mod-bee/modbee-node-uio/images/modbee-node-uio-connections-wh.webp

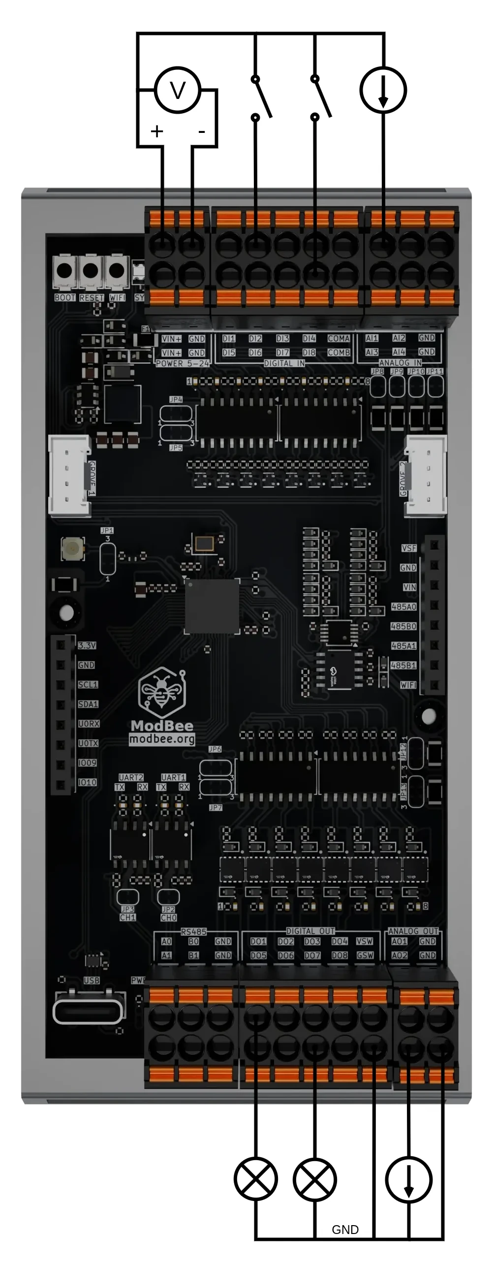
images/modbee-node-uio-connections-wh.webp
