mod-bee/modbee-node-uio/images/node-uio-br-1.webp

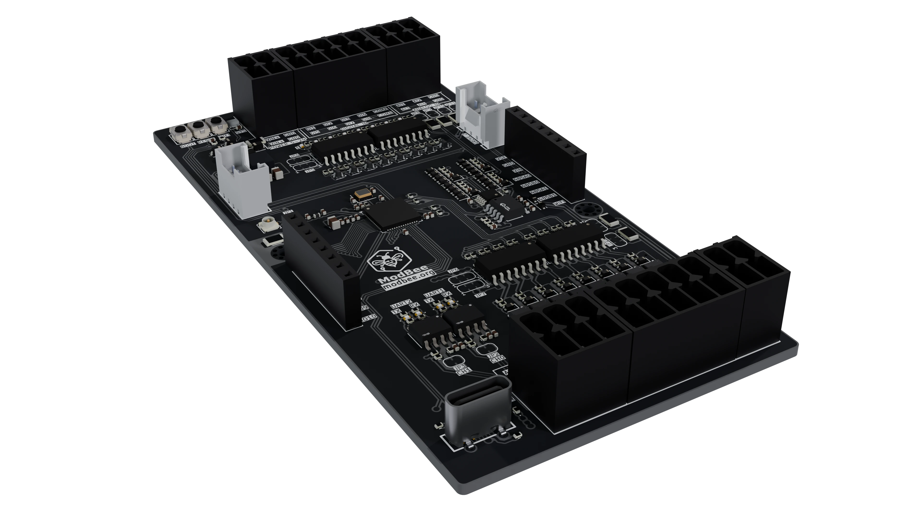
images/node-uio-br-1.webp
