mod-bee/modbee-node-uio/images/node-uio-br-2.webp

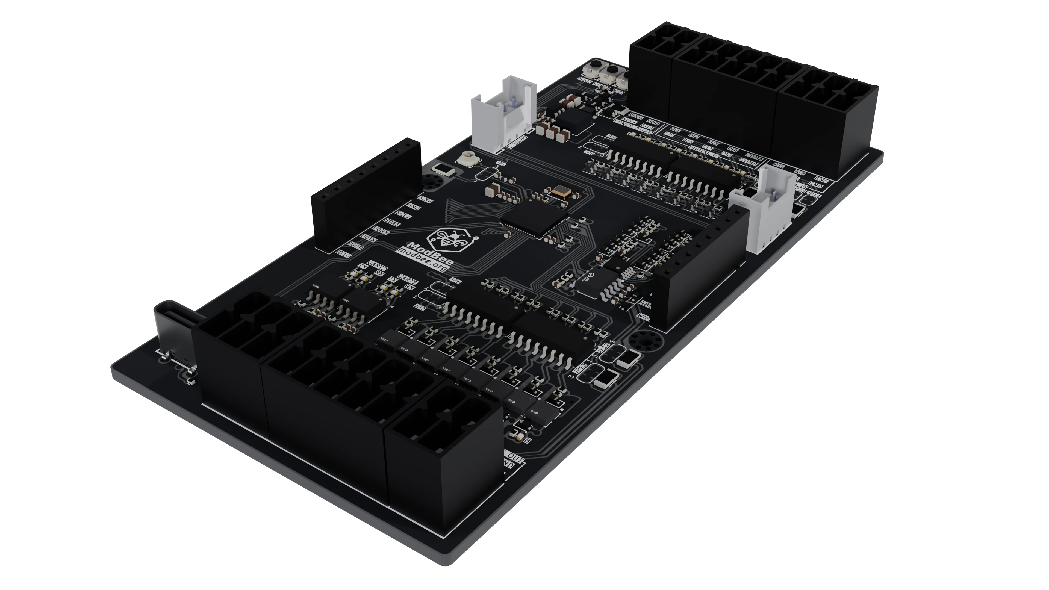
images/node-uio-br-2.webp
