mod-bee/modbee-node-uio/images/node-uio-br-3.webp

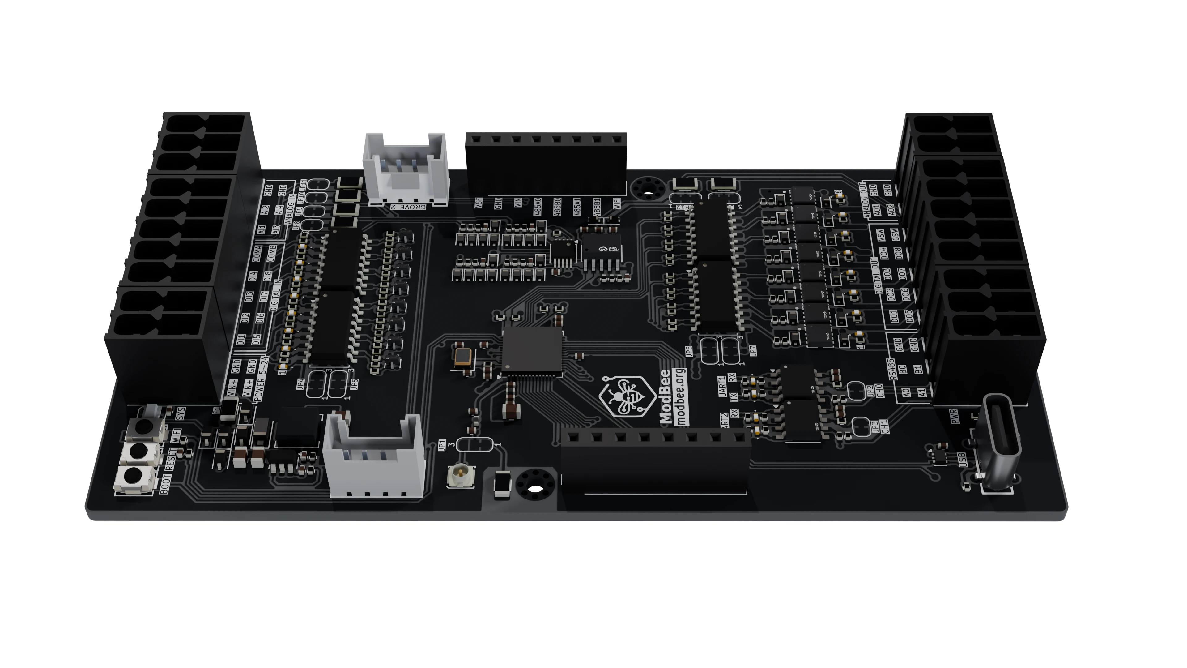
images/node-uio-br-3.webp
