mod-bee/modbee-node-uio/images/node-uio-br-4.webp

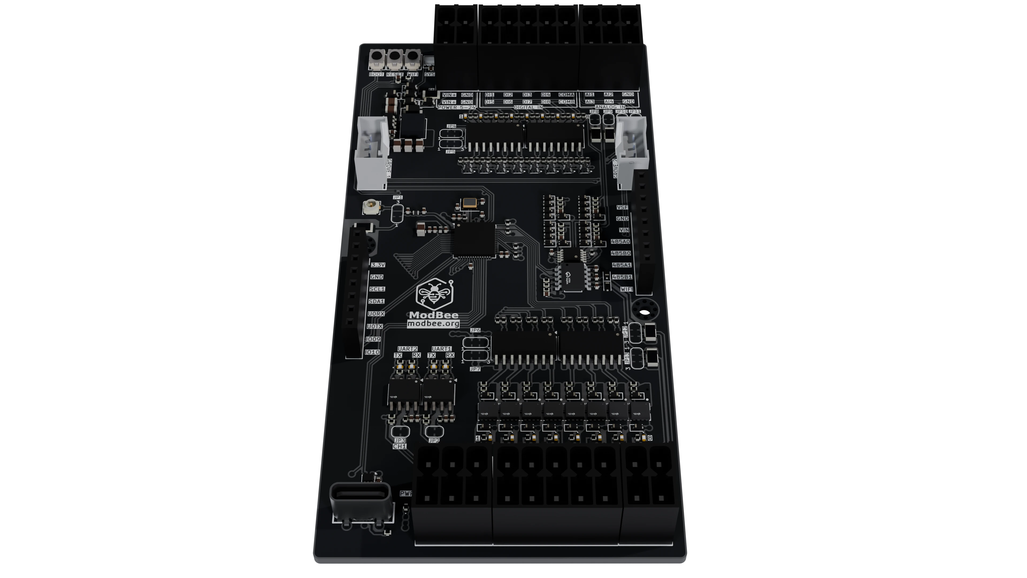
images/node-uio-br-4.webp
