mod-bee/modbee-node-uio/images/node-uio-br-assem-2.webp

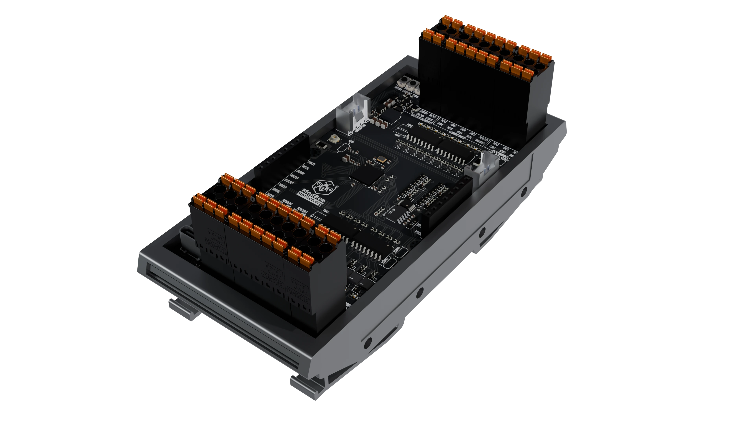
images/node-uio-br-assem-2.webp
