mod-bee/modbee-node-uio/images/node-uio-br-assem-3.webp

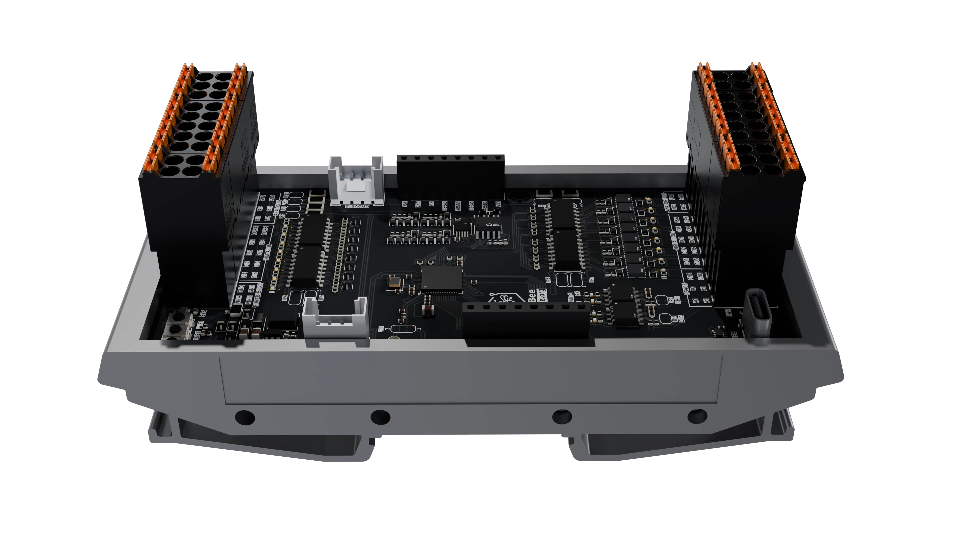
images/node-uio-br-assem-3.webp
