mod-bee/modbee-node-uio/images/node-uio-br-assem-hat-loramesh-1.webp

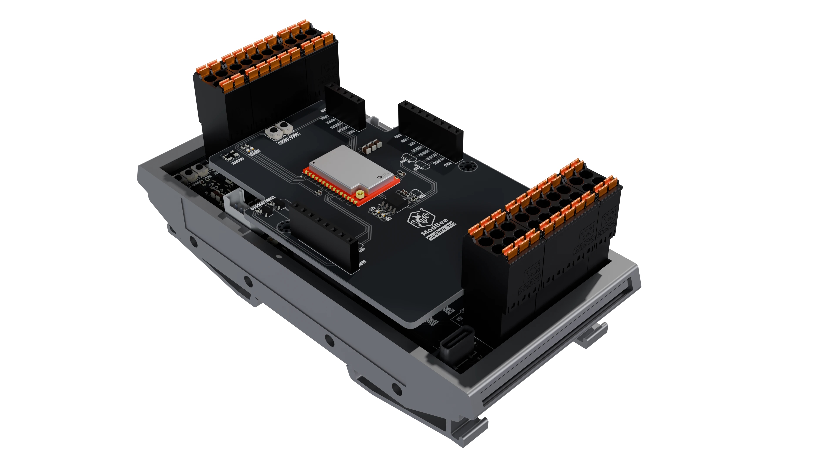
images/node-uio-br-assem-hat-loramesh-1.webp
