mod-bee/modbee-node-uio/images/node-uio-br-assem-hat-loramesh-3.webp

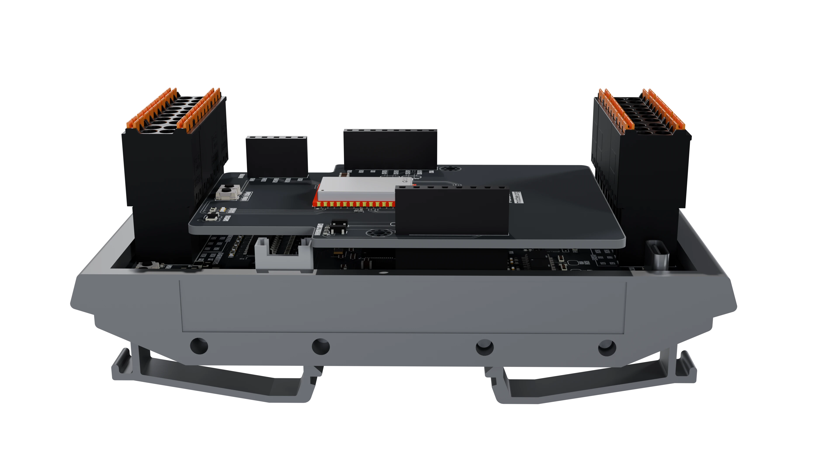
images/node-uio-br-assem-hat-loramesh-3.webp
