mod-bee/modbee-node-uio/images/node-uio-top.webp

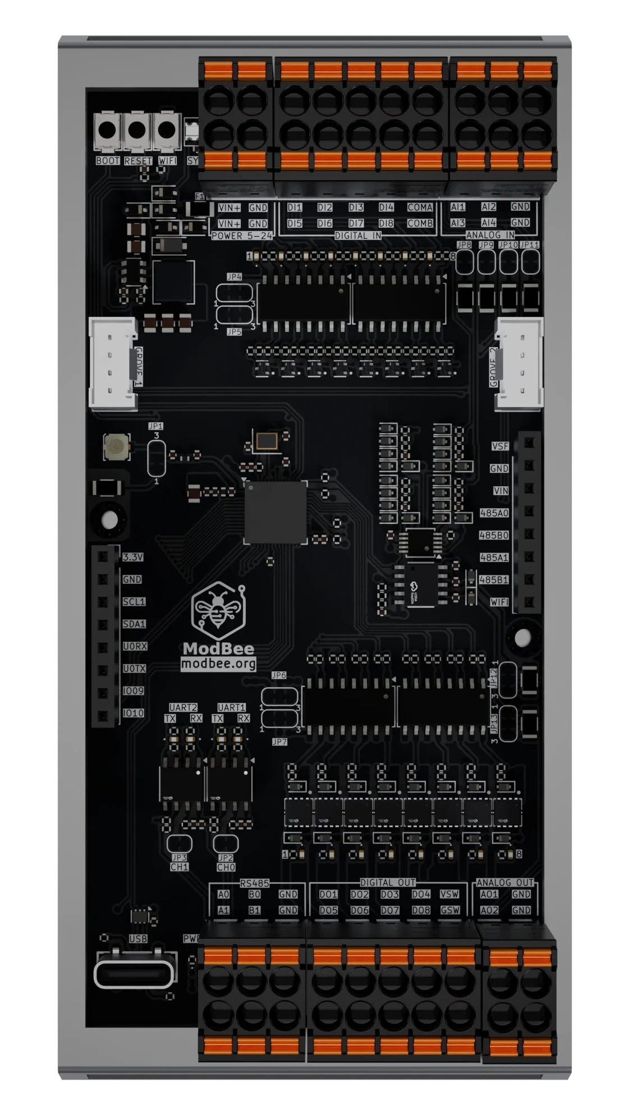
images/node-uio-top.webp
