mod-bee/modbee-node-uio/openPLC/projects/Modbee-MB-Master-Array/build/ESP32-S3/src/VARIABLES.csv

// Programs
0 | CONFIG0.RES0.INSTANCE0 | MAIN
1 | CONFIG0.RES0.INSTANCE1 | MODBEE
// Variables
0 | FB | CONFIG0.RES0.INSTANCE0 | CONFIG0.RES0.INSTANCE0 | MAIN |  | 0
1 | FB | CONFIG0.RES0.INSTANCE0.MODBEE_HW_INPUTS0 | CONFIG0.RES0.INSTANCE0.MODBEE_HW_INPUTS0 | MODBEE_HW_INPUTS |  | 0
2 | VAR | CONFIG0.RES0.INSTANCE0.MODBEE_HW_INPUTS0.EN | CONFIG0.RES0.INSTANCE0.MODBEE_HW_INPUTS0.EN | BOOL | BOOL | 0
3 | VAR | CONFIG0.RES0.INSTANCE0.MODBEE_HW_INPUTS0.ENO | CONFIG0.RES0.INSTANCE0.MODBEE_HW_INPUTS0.ENO | BOOL | BOOL | 0
4 | VAR | CONFIG0.RES0.INSTANCE0.MODBEE_HW_INPUTS0.DX01 | CONFIG0.RES0.INSTANCE0.MODBEE_HW_INPUTS0.DX01 | BOOL | BOOL | 0
5 | VAR | CONFIG0.RES0.INSTANCE0.MODBEE_HW_INPUTS0.DX02 | CONFIG0.RES0.INSTANCE0.MODBEE_HW_INPUTS0.DX02 | BOOL | BOOL | 0
6 | VAR | CONFIG0.RES0.INSTANCE0.MODBEE_HW_INPUTS0.DX03 | CONFIG0.RES0.INSTANCE0.MODBEE_HW_INPUTS0.DX03 | BOOL | BOOL | 0
7 | VAR | CONFIG0.RES0.INSTANCE0.MODBEE_HW_INPUTS0.DX04 | CONFIG0.RES0.INSTANCE0.MODBEE_HW_INPUTS0.DX04 | BOOL | BOOL | 0
8 | VAR | CONFIG0.RES0.INSTANCE0.MODBEE_HW_INPUTS0.DX05 | CONFIG0.RES0.INSTANCE0.MODBEE_HW_INPUTS0.DX05 | BOOL | BOOL | 0
9 | VAR | CONFIG0.RES0.INSTANCE0.MODBEE_HW_INPUTS0.DX06 | CONFIG0.RES0.INSTANCE0.MODBEE_HW_INPUTS0.DX06 | BOOL | BOOL | 0
10 | VAR | CONFIG0.RES0.INSTANCE0.MODBEE_HW_INPUTS0.DX07 | CONFIG0.RES0.INSTANCE0.MODBEE_HW_INPUTS0.DX07 | BOOL | BOOL | 0
11 | VAR | CONFIG0.RES0.INSTANCE0.MODBEE_HW_INPUTS0.DX08 | CONFIG0.RES0.INSTANCE0.MODBEE_HW_INPUTS0.DX08 | BOOL | BOOL | 0
12 | VAR | CONFIG0.RES0.INSTANCE0.MODBEE_HW_INPUTS0.AX01_SCALED | CONFIG0.RES0.INSTANCE0.MODBEE_HW_INPUTS0.AX01_SCALED | REAL | REAL | 0
13 | VAR | CONFIG0.RES0.INSTANCE0.MODBEE_HW_INPUTS0.AX02_SCALED | CONFIG0.RES0.INSTANCE0.MODBEE_HW_INPUTS0.AX02_SCALED | REAL | REAL | 0
14 | VAR | CONFIG0.RES0.INSTANCE0.MODBEE_HW_INPUTS0.AX03_SCALED | CONFIG0.RES0.INSTANCE0.MODBEE_HW_INPUTS0.AX03_SCALED | REAL | REAL | 0
15 | VAR | CONFIG0.RES0.INSTANCE0.MODBEE_HW_INPUTS0.AX04_SCALED | CONFIG0.RES0.INSTANCE0.MODBEE_HW_INPUTS0.AX04_SCALED | REAL | REAL | 0
16 | VAR | CONFIG0.RES0.INSTANCE0.MODBEE_HW_INPUTS0.HASBEENINITIALIZED | CONFIG0.RES0.INSTANCE0.MODBEE_HW_INPUTS0.HASBEENINITIALIZED | BOOL | BOOL | 0
17 | FB | CONFIG0.RES0.INSTANCE0.MODBEE_HW_OUTPUTS0 | CONFIG0.RES0.INSTANCE0.MODBEE_HW_OUTPUTS0 | MODBEE_HW_OUTPUTS |  | 0
18 | VAR | CONFIG0.RES0.INSTANCE0.MODBEE_HW_OUTPUTS0.EN | CONFIG0.RES0.INSTANCE0.MODBEE_HW_OUTPUTS0.EN | BOOL | BOOL | 0
19 | VAR | CONFIG0.RES0.INSTANCE0.MODBEE_HW_OUTPUTS0.ENO | CONFIG0.RES0.INSTANCE0.MODBEE_HW_OUTPUTS0.ENO | BOOL | BOOL | 0
20 | VAR | CONFIG0.RES0.INSTANCE0.MODBEE_HW_OUTPUTS0.DY01 | CONFIG0.RES0.INSTANCE0.MODBEE_HW_OUTPUTS0.DY01 | BOOL | BOOL | 0
21 | VAR | CONFIG0.RES0.INSTANCE0.MODBEE_HW_OUTPUTS0.DY02 | CONFIG0.RES0.INSTANCE0.MODBEE_HW_OUTPUTS0.DY02 | BOOL | BOOL | 0
22 | VAR | CONFIG0.RES0.INSTANCE0.MODBEE_HW_OUTPUTS0.DY03 | CONFIG0.RES0.INSTANCE0.MODBEE_HW_OUTPUTS0.DY03 | BOOL | BOOL | 0
23 | VAR | CONFIG0.RES0.INSTANCE0.MODBEE_HW_OUTPUTS0.DY04 | CONFIG0.RES0.INSTANCE0.MODBEE_HW_OUTPUTS0.DY04 | BOOL | BOOL | 0
24 | VAR | CONFIG0.RES0.INSTANCE0.MODBEE_HW_OUTPUTS0.DY05 | CONFIG0.RES0.INSTANCE0.MODBEE_HW_OUTPUTS0.DY05 | BOOL | BOOL | 0
25 | VAR | CONFIG0.RES0.INSTANCE0.MODBEE_HW_OUTPUTS0.DY06 | CONFIG0.RES0.INSTANCE0.MODBEE_HW_OUTPUTS0.DY06 | BOOL | BOOL | 0
26 | VAR | CONFIG0.RES0.INSTANCE0.MODBEE_HW_OUTPUTS0.DY07 | CONFIG0.RES0.INSTANCE0.MODBEE_HW_OUTPUTS0.DY07 | BOOL | BOOL | 0
27 | VAR | CONFIG0.RES0.INSTANCE0.MODBEE_HW_OUTPUTS0.DY08 | CONFIG0.RES0.INSTANCE0.MODBEE_HW_OUTPUTS0.DY08 | BOOL | BOOL | 0
28 | VAR | CONFIG0.RES0.INSTANCE0.MODBEE_HW_OUTPUTS0.AY01_SCALED | CONFIG0.RES0.INSTANCE0.MODBEE_HW_OUTPUTS0.AY01_SCALED | REAL | REAL | 0
29 | VAR | CONFIG0.RES0.INSTANCE0.MODBEE_HW_OUTPUTS0.AY02_SCALED | CONFIG0.RES0.INSTANCE0.MODBEE_HW_OUTPUTS0.AY02_SCALED | REAL | REAL | 0
30 | VAR | CONFIG0.RES0.INSTANCE0.MODBEE_HW_OUTPUTS0.HASBEENINITIALIZED | CONFIG0.RES0.INSTANCE0.MODBEE_HW_OUTPUTS0.HASBEENINITIALIZED | BOOL | BOOL | 0
31 | VAR | CONFIG0.RES0.INSTANCE0.START | CONFIG0.RES0.INSTANCE0.START | BOOL | BOOL | 0
32 | VAR | CONFIG0.RES0.INSTANCE0.STOP | CONFIG0.RES0.INSTANCE0.STOP | BOOL | BOOL | 0
33 | VAR | CONFIG0.RES0.INSTANCE0.RUN | CONFIG0.RES0.INSTANCE0.RUN | BOOL | BOOL | 0
34 | VAR | CONFIG0.RES0.INSTANCE0.MB_SLAVE_DO.value.table[0] | CONFIG0.RES0.INSTANCE0.MB_SLAVE_DO.value.table[0] | BOOL | BOOL | 0
35 | VAR | CONFIG0.RES0.INSTANCE0.MB_SLAVE_DO.value.table[1] | CONFIG0.RES0.INSTANCE0.MB_SLAVE_DO.value.table[1] | BOOL | BOOL | 0
36 | VAR | CONFIG0.RES0.INSTANCE0.MB_SLAVE_DO.value.table[2] | CONFIG0.RES0.INSTANCE0.MB_SLAVE_DO.value.table[2] | BOOL | BOOL | 0
37 | VAR | CONFIG0.RES0.INSTANCE0.MB_SLAVE_DO.value.table[3] | CONFIG0.RES0.INSTANCE0.MB_SLAVE_DO.value.table[3] | BOOL | BOOL | 0
38 | VAR | CONFIG0.RES0.INSTANCE0.MB_SLAVE_DO.value.table[4] | CONFIG0.RES0.INSTANCE0.MB_SLAVE_DO.value.table[4] | BOOL | BOOL | 0
39 | VAR | CONFIG0.RES0.INSTANCE0.MB_SLAVE_DO.value.table[5] | CONFIG0.RES0.INSTANCE0.MB_SLAVE_DO.value.table[5] | BOOL | BOOL | 0
40 | VAR | CONFIG0.RES0.INSTANCE0.MB_SLAVE_DO.value.table[6] | CONFIG0.RES0.INSTANCE0.MB_SLAVE_DO.value.table[6] | BOOL | BOOL | 0
41 | VAR | CONFIG0.RES0.INSTANCE0.MB_SLAVE_DO.value.table[7] | CONFIG0.RES0.INSTANCE0.MB_SLAVE_DO.value.table[7] | BOOL | BOOL | 0
42 | VAR | CONFIG0.RES0.INSTANCE0.MB_SLAVE_DO.value.table[8] | CONFIG0.RES0.INSTANCE0.MB_SLAVE_DO.value.table[8] | BOOL | BOOL | 0
43 | VAR | CONFIG0.RES0.INSTANCE0.MB_SLAVE_DO.value.table[9] | CONFIG0.RES0.INSTANCE0.MB_SLAVE_DO.value.table[9] | BOOL | BOOL | 0
44 | VAR | CONFIG0.RES0.INSTANCE0.MB_SLAVE_DO.value.table[10] | CONFIG0.RES0.INSTANCE0.MB_SLAVE_DO.value.table[10] | BOOL | BOOL | 0
45 | VAR | CONFIG0.RES0.INSTANCE0.MB_SLAVE_DO.value.table[11] | CONFIG0.RES0.INSTANCE0.MB_SLAVE_DO.value.table[11] | BOOL | BOOL | 0
46 | VAR | CONFIG0.RES0.INSTANCE0.MB_SLAVE_DO.value.table[12] | CONFIG0.RES0.INSTANCE0.MB_SLAVE_DO.value.table[12] | BOOL | BOOL | 0
47 | VAR | CONFIG0.RES0.INSTANCE0.MB_SLAVE_DO.value.table[13] | CONFIG0.RES0.INSTANCE0.MB_SLAVE_DO.value.table[13] | BOOL | BOOL | 0
48 | VAR | CONFIG0.RES0.INSTANCE0.MB_SLAVE_DO.value.table[14] | CONFIG0.RES0.INSTANCE0.MB_SLAVE_DO.value.table[14] | BOOL | BOOL | 0
49 | VAR | CONFIG0.RES0.INSTANCE0.MB_SLAVE_DO.value.table[15] | CONFIG0.RES0.INSTANCE0.MB_SLAVE_DO.value.table[15] | BOOL | BOOL | 0
50 | VAR | CONFIG0.RES0.INSTANCE0.MB_SLAVE_DO.value.table[16] | CONFIG0.RES0.INSTANCE0.MB_SLAVE_DO.value.table[16] | BOOL | BOOL | 0
51 | VAR | CONFIG0.RES0.INSTANCE0.MB_SLAVE_DO.value.table[17] | CONFIG0.RES0.INSTANCE0.MB_SLAVE_DO.value.table[17] | BOOL | BOOL | 0
52 | VAR | CONFIG0.RES0.INSTANCE0.MB_SLAVE_DO.value.table[18] | CONFIG0.RES0.INSTANCE0.MB_SLAVE_DO.value.table[18] | BOOL | BOOL | 0
53 | VAR | CONFIG0.RES0.INSTANCE0.MB_SLAVE_DO.value.table[19] | CONFIG0.RES0.INSTANCE0.MB_SLAVE_DO.value.table[19] | BOOL | BOOL | 0
54 | VAR | CONFIG0.RES0.INSTANCE0.MB_SLAVE_DO.value.table[20] | CONFIG0.RES0.INSTANCE0.MB_SLAVE_DO.value.table[20] | BOOL | BOOL | 0
55 | VAR | CONFIG0.RES0.INSTANCE0.MB_SLAVE_DO.value.table[21] | CONFIG0.RES0.INSTANCE0.MB_SLAVE_DO.value.table[21] | BOOL | BOOL | 0
56 | VAR | CONFIG0.RES0.INSTANCE0.MB_SLAVE_DO.value.table[22] | CONFIG0.RES0.INSTANCE0.MB_SLAVE_DO.value.table[22] | BOOL | BOOL | 0
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
88 | VAR | CONFIG0.RES0.INSTANCE0.MB_SLAVE_DI.value.table[22] | CONFIG0.RES0.INSTANCE0.MB_SLAVE_DI.value.table[22] | BOOL | BOOL | 0
89 | VAR | CONFIG0.RES0.INSTANCE0.MB_SLAVE_DI.value.table[23] | CONFIG0.RES0.INSTANCE0.MB_SLAVE_DI.value.table[23] | BOOL | BOOL | 0
90 | VAR | CONFIG0.RES0.INSTANCE0.MB_SLAVE_DI.value.table[24] | CONFIG0.RES0.INSTANCE0.MB_SLAVE_DI.value.table[24] | BOOL | BOOL | 0
91 | VAR | CONFIG0.RES0.INSTANCE0.MB_SLAVE_DI.value.table[25] | CONFIG0.RES0.INSTANCE0.MB_SLAVE_DI.value.table[25] | BOOL | BOOL | 0
92 | VAR | CONFIG0.RES0.INSTANCE0.MB_SLAVE_DI.value.table[26] | CONFIG0.RES0.INSTANCE0.MB_SLAVE_DI.value.table[26] | BOOL | BOOL | 0
93 | VAR | CONFIG0.RES0.INSTANCE0.MB_SLAVE_DI.value.table[27] | CONFIG0.RES0.INSTANCE0.MB_SLAVE_DI.value.table[27] | BOOL | BOOL | 0
94 | VAR | CONFIG0.RES0.INSTANCE0.MB_SLAVE_DI.value.table[28] | CONFIG0.RES0.INSTANCE0.MB_SLAVE_DI.value.table[28] | BOOL | BOOL | 0
95 | VAR | CONFIG0.RES0.INSTANCE0.MB_SLAVE_DI.value.table[29] | CONFIG0.RES0.INSTANCE0.MB_SLAVE_DI.value.table[29] | BOOL | BOOL | 0
96 | VAR | CONFIG0.RES0.INSTANCE0.MB_SLAVE_DI.value.table[30] | CONFIG0.RES0.INSTANCE0.MB_SLAVE_DI.value.table[30] | BOOL | BOOL | 0
97 | VAR | CONFIG0.RES0.INSTANCE0.MB_SLAVE_DI.value.table[31] | CONFIG0.RES0.INSTANCE0.MB_SLAVE_DI.value.table[31] | BOOL | BOOL | 0
98 | VAR | CONFIG0.RES0.INSTANCE0.MB_WRITE_COILS_DONE | CONFIG0.RES0.INSTANCE0.MB_WRITE_COILS_DONE | BOOL | BOOL | 0
99 | VAR | CONFIG0.RES0.INSTANCE0.MB_READ_COILS_DONE | CONFIG0.RES0.INSTANCE0.MB_READ_COILS_DONE | BOOL | BOOL | 0
100 | FB | CONFIG0.RES0.INSTANCE0.TON0 | CONFIG0.RES0.INSTANCE0.TON0 | TON |  | 0
101 | VAR | CONFIG0.RES0.INSTANCE0.TON0.EN | CONFIG0.RES0.INSTANCE0.TON0.EN | BOOL | BOOL | 0
102 | VAR | CONFIG0.RES0.INSTANCE0.TON0.ENO | CONFIG0.RES0.INSTANCE0.TON0.ENO | BOOL | BOOL | 0
103 | VAR | CONFIG0.RES0.INSTANCE0.TON0.IN | CONFIG0.RES0.INSTANCE0.TON0.IN | BOOL | BOOL | 0
104 | VAR | CONFIG0.RES0.INSTANCE0.TON0.PT | CONFIG0.RES0.INSTANCE0.TON0.PT | TIME | TIME | 0
105 | VAR | CONFIG0.RES0.INSTANCE0.TON0.Q | CONFIG0.RES0.INSTANCE0.TON0.Q | BOOL | BOOL | 0
106 | VAR | CONFIG0.RES0.INSTANCE0.TON0.ET | CONFIG0.RES0.INSTANCE0.TON0.ET | TIME | TIME | 0
107 | VAR | CONFIG0.RES0.INSTANCE0.TON0.STATE | CONFIG0.RES0.INSTANCE0.TON0.STATE | SINT | SINT | 0
108 | VAR | CONFIG0.RES0.INSTANCE0.TON0.PREV_IN | CONFIG0.RES0.INSTANCE0.TON0.PREV_IN | BOOL | BOOL | 0
109 | VAR | CONFIG0.RES0.INSTANCE0.TON0.CURRENT_TIME | CONFIG0.RES0.INSTANCE0.TON0.CURRENT_TIME | TIME | TIME | 0
110 | VAR | CONFIG0.RES0.INSTANCE0.TON0.START_TIME | CONFIG0.RES0.INSTANCE0.TON0.START_TIME | TIME | TIME | 0
111 | FB | CONFIG0.RES0.INSTANCE0.TON1 | CONFIG0.RES0.INSTANCE0.TON1 | TON |  | 0
112 | VAR | CONFIG0.RES0.INSTANCE0.TON1.EN | CONFIG0.RES0.INSTANCE0.TON1.EN | BOOL | BOOL | 0
113 | VAR | CONFIG0.RES0.INSTANCE0.TON1.ENO | CONFIG0.RES0.INSTANCE0.TON1.ENO | BOOL | BOOL | 0
114 | VAR | CONFIG0.RES0.INSTANCE0.TON1.IN | CONFIG0.RES0.INSTANCE0.TON1.IN | BOOL | BOOL | 0
115 | VAR | CONFIG0.RES0.INSTANCE0.TON1.PT | CONFIG0.RES0.INSTANCE0.TON1.PT | TIME | TIME | 0
116 | VAR | CONFIG0.RES0.INSTANCE0.TON1.Q | CONFIG0.RES0.INSTANCE0.TON1.Q | BOOL | BOOL | 0
117 | VAR | CONFIG0.RES0.INSTANCE0.TON1.ET | CONFIG0.RES0.INSTANCE0.TON1.ET | TIME | TIME | 0
118 | VAR | CONFIG0.RES0.INSTANCE0.TON1.STATE | CONFIG0.RES0.INSTANCE0.TON1.STATE | SINT | SINT | 0
119 | VAR | CONFIG0.RES0.INSTANCE0.TON1.PREV_IN | CONFIG0.RES0.INSTANCE0.TON1.PREV_IN | BOOL | BOOL | 0
120 | VAR | CONFIG0.RES0.INSTANCE0.TON1.CURRENT_TIME | CONFIG0.RES0.INSTANCE0.TON1.CURRENT_TIME | TIME | TIME | 0
121 | VAR | CONFIG0.RES0.INSTANCE0.TON1.START_TIME | CONFIG0.RES0.INSTANCE0.TON1.START_TIME | TIME | TIME | 0
122 | VAR | CONFIG0.RES0.INSTANCE0.TON1_DONE | CONFIG0.RES0.INSTANCE0.TON1_DONE | BOOL | BOOL | 0
123 | VAR | CONFIG0.RES0.INSTANCE0.TON0_DONE | CONFIG0.RES0.INSTANCE0.TON0_DONE | BOOL | BOOL | 0
124 | VAR | CONFIG0.RES0.INSTANCE0.MB_READ_REGS_DONE | CONFIG0.RES0.INSTANCE0.MB_READ_REGS_DONE | BOOL | BOOL | 0
125 | VAR | CONFIG0.RES0.INSTANCE0.MB_SLAVE_AI.value.table[0] | CONFIG0.RES0.INSTANCE0.MB_SLAVE_AI.value.table[0] | INT | INT | 0
126 | VAR | CONFIG0.RES0.INSTANCE0.MB_SLAVE_AI.value.table[1] | CONFIG0.RES0.INSTANCE0.MB_SLAVE_AI.value.table[1] | INT | INT | 0
127 | VAR | CONFIG0.RES0.INSTANCE0.MB_SLAVE_AI.value.table[2] | CONFIG0.RES0.INSTANCE0.MB_SLAVE_AI.value.table[2] | INT | INT | 0
128 | VAR | CONFIG0.RES0.INSTANCE0.MB_SLAVE_AI.value.table[3] | CONFIG0.RES0.INSTANCE0.MB_SLAVE_AI.value.table[3] | INT | INT | 0
129 | VAR | CONFIG0.RES0.INSTANCE0.MB_SLAVE_AI.value.table[4] | CONFIG0.RES0.INSTANCE0.MB_SLAVE_AI.value.table[4] | INT | INT | 0
130 | VAR | CONFIG0.RES0.INSTANCE0.MB_SLAVE_AI.value.table[5] | CONFIG0.RES0.INSTANCE0.MB_SLAVE_AI.value.table[5] | INT | INT | 0
131 | VAR | CONFIG0.RES0.INSTANCE0.MB_SLAVE_AI.value.table[6] | CONFIG0.RES0.INSTANCE0.MB_SLAVE_AI.value.table[6] | INT | INT | 0
132 | VAR | CONFIG0.RES0.INSTANCE0.MB_SLAVE_AI.value.table[7] | CONFIG0.RES0.INSTANCE0.MB_SLAVE_AI.value.table[7] | INT | INT | 0
133 | VAR | CONFIG0.RES0.INSTANCE0.MB_SLAVE_AI.value.table[8] | CONFIG0.RES0.INSTANCE0.MB_SLAVE_AI.value.table[8] | INT | INT | 0
134 | VAR | CONFIG0.RES0.INSTANCE0.MB_SLAVE_AI.value.table[9] | CONFIG0.RES0.INSTANCE0.MB_SLAVE_AI.value.table[9] | INT | INT | 0
135 | VAR | CONFIG0.RES0.INSTANCE0.MB_SLAVE_AI.value.table[10] | CONFIG0.RES0.INSTANCE0.MB_SLAVE_AI.value.table[10] | INT | INT | 0
136 | VAR | CONFIG0.RES0.INSTANCE0.MB_SLAVE_AI.value.table[11] | CONFIG0.RES0.INSTANCE0.MB_SLAVE_AI.value.table[11] | INT | INT | 0
137 | VAR | CONFIG0.RES0.INSTANCE0.MB_SLAVE_AI.value.table[12] | CONFIG0.RES0.INSTANCE0.MB_SLAVE_AI.value.table[12] | INT | INT | 0
138 | VAR | CONFIG0.RES0.INSTANCE0.MB_SLAVE_AI.value.table[13] | CONFIG0.RES0.INSTANCE0.MB_SLAVE_AI.value.table[13] | INT | INT | 0
139 | VAR | CONFIG0.RES0.INSTANCE0.MB_SLAVE_AI.value.table[14] | CONFIG0.RES0.INSTANCE0.MB_SLAVE_AI.value.table[14] | INT | INT | 0
140 | VAR | CONFIG0.RES0.INSTANCE0.MB_SLAVE_AI.value.table[15] | CONFIG0.RES0.INSTANCE0.MB_SLAVE_AI.value.table[15] | INT | INT | 0
141 | VAR | CONFIG0.RES0.INSTANCE0.MB_SLAVE_AI.value.table[16] | CONFIG0.RES0.INSTANCE0.MB_SLAVE_AI.value.table[16] | INT | INT | 0
142 | VAR | CONFIG0.RES0.INSTANCE0.MB_SLAVE_AI.value.table[17] | CONFIG0.RES0.INSTANCE0.MB_SLAVE_AI.value.table[17] | INT | INT | 0
143 | VAR | CONFIG0.RES0.INSTANCE0.MB_SLAVE_AI.value.table[18] | CONFIG0.RES0.INSTANCE0.MB_SLAVE_AI.value.table[18] | INT | INT | 0
144 | VAR | CONFIG0.RES0.INSTANCE0.MB_SLAVE_AI.value.table[19] | CONFIG0.RES0.INSTANCE0.MB_SLAVE_AI.value.table[19] | INT | INT | 0
145 | VAR | CONFIG0.RES0.INSTANCE0.MB_SLAVE_AI.value.table[20] | CONFIG0.RES0.INSTANCE0.MB_SLAVE_AI.value.table[20] | INT | INT | 0
146 | VAR | CONFIG0.RES0.INSTANCE0.MB_SLAVE_AI.value.table[21] | CONFIG0.RES0.INSTANCE0.MB_SLAVE_AI.value.table[21] | INT | INT | 0
147 | VAR | CONFIG0.RES0.INSTANCE0.MB_SLAVE_AI.value.table[22] | CONFIG0.RES0.INSTANCE0.MB_SLAVE_AI.value.table[22] | INT | INT | 0
148 | VAR | CONFIG0.RES0.INSTANCE0.MB_SLAVE_AI.value.table[23] | CONFIG0.RES0.INSTANCE0.MB_SLAVE_AI.value.table[23] | INT | INT | 0
149 | VAR | CONFIG0.RES0.INSTANCE0.MB_SLAVE_AI.value.table[24] | CONFIG0.RES0.INSTANCE0.MB_SLAVE_AI.value.table[24] | INT | INT | 0
150 | VAR | CONFIG0.RES0.INSTANCE0.MB_SLAVE_AI.value.table[25] | CONFIG0.RES0.INSTANCE0.MB_SLAVE_AI.value.table[25] | INT | INT | 0
151 | VAR | CONFIG0.RES0.INSTANCE0.MB_SLAVE_AI.value.table[26] | CONFIG0.RES0.INSTANCE0.MB_SLAVE_AI.value.table[26] | INT | INT | 0
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
358 | VAR | CONFIG0.RES0.INSTANCE0.MODBUS_READ_ARRAY1.REGS.value.table[18] | CONFIG0.RES0.INSTANCE0.MODBUS_READ_ARRAY1.REGS.value.table[18] | INT | INT | 0
359 | VAR | CONFIG0.RES0.INSTANCE0.MODBUS_READ_ARRAY1.REGS.value.table[19] | CONFIG0.RES0.INSTANCE0.MODBUS_READ_ARRAY1.REGS.value.table[19] | INT | INT | 0
360 | VAR | CONFIG0.RES0.INSTANCE0.MODBUS_READ_ARRAY1.REGS.value.table[20] | CONFIG0.RES0.INSTANCE0.MODBUS_READ_ARRAY1.REGS.value.table[20] | INT | INT | 0
361 | VAR | CONFIG0.RES0.INSTANCE0.MODBUS_READ_ARRAY1.REGS.value.table[21] | CONFIG0.RES0.INSTANCE0.MODBUS_READ_ARRAY1.REGS.value.table[21] | INT | INT | 0
362 | VAR | CONFIG0.RES0.INSTANCE0.MODBUS_READ_ARRAY1.REGS.value.table[22] | CONFIG0.RES0.INSTANCE0.MODBUS_READ_ARRAY1.REGS.value.table[22] | INT | INT | 0
363 | VAR | CONFIG0.RES0.INSTANCE0.MODBUS_READ_ARRAY1.REGS.value.table[23] | CONFIG0.RES0.INSTANCE0.MODBUS_READ_ARRAY1.REGS.value.table[23] | INT | INT | 0
364 | VAR | CONFIG0.RES0.INSTANCE0.MODBUS_READ_ARRAY1.REGS.value.table[24] | CONFIG0.RES0.INSTANCE0.MODBUS_READ_ARRAY1.REGS.value.table[24] | INT | INT | 0
365 | VAR | CONFIG0.RES0.INSTANCE0.MODBUS_READ_ARRAY1.REGS.value.table[25] | CONFIG0.RES0.INSTANCE0.MODBUS_READ_ARRAY1.REGS.value.table[25] | INT | INT | 0
366 | VAR | CONFIG0.RES0.INSTANCE0.MODBUS_READ_ARRAY1.REGS.value.table[26] | CONFIG0.RES0.INSTANCE0.MODBUS_READ_ARRAY1.REGS.value.table[26] | INT | INT | 0
367 | VAR | CONFIG0.RES0.INSTANCE0.MODBUS_READ_ARRAY1.REGS.value.table[27] | CONFIG0.RES0.INSTANCE0.MODBUS_READ_ARRAY1.REGS.value.table[27] | INT | INT | 0
368 | VAR | CONFIG0.RES0.INSTANCE0.MODBUS_READ_ARRAY1.REGS.value.table[28] | CONFIG0.RES0.INSTANCE0.MODBUS_READ_ARRAY1.REGS.value.table[28] | INT | INT | 0
369 | VAR | CONFIG0.RES0.INSTANCE0.MODBUS_READ_ARRAY1.REGS.value.table[29] | CONFIG0.RES0.INSTANCE0.MODBUS_READ_ARRAY1.REGS.value.table[29] | INT | INT | 0
370 | VAR | CONFIG0.RES0.INSTANCE0.MODBUS_READ_ARRAY1.REGS.value.table[30] | CONFIG0.RES0.INSTANCE0.MODBUS_READ_ARRAY1.REGS.value.table[30] | INT | INT | 0
371 | VAR | CONFIG0.RES0.INSTANCE0.MODBUS_READ_ARRAY1.REGS.value.table[31] | CONFIG0.RES0.INSTANCE0.MODBUS_READ_ARRAY1.REGS.value.table[31] | INT | INT | 0
372 | VAR | CONFIG0.RES0.INSTANCE0.MODBUS_READ_ARRAY1.HASBEENINITIALIZED | CONFIG0.RES0.INSTANCE0.MODBUS_READ_ARRAY1.HASBEENINITIALIZED | BOOL | BOOL | 0
373 | FB | CONFIG0.RES0.INSTANCE0.MODBUS_WRITE_ARRAY0 | CONFIG0.RES0.INSTANCE0.MODBUS_WRITE_ARRAY0 | MODBUS_WRITE_ARRAY |  | 0
374 | VAR | CONFIG0.RES0.INSTANCE0.MODBUS_WRITE_ARRAY0.EN | CONFIG0.RES0.INSTANCE0.MODBUS_WRITE_ARRAY0.EN | BOOL | BOOL | 0
375 | VAR | CONFIG0.RES0.INSTANCE0.MODBUS_WRITE_ARRAY0.ENO | CONFIG0.RES0.INSTANCE0.MODBUS_WRITE_ARRAY0.ENO | BOOL | BOOL | 0
376 | VAR | CONFIG0.RES0.INSTANCE0.MODBUS_WRITE_ARRAY0.REQ | CONFIG0.RES0.INSTANCE0.MODBUS_WRITE_ARRAY0.REQ | BOOL | BOOL | 0
377 | VAR | CONFIG0.RES0.INSTANCE0.MODBUS_WRITE_ARRAY0.SLAVE_ID | CONFIG0.RES0.INSTANCE0.MODBUS_WRITE_ARRAY0.SLAVE_ID | BYTE | BYTE | 0
378 | VAR | CONFIG0.RES0.INSTANCE0.MODBUS_WRITE_ARRAY0.REG_TYPE | CONFIG0.RES0.INSTANCE0.MODBUS_WRITE_ARRAY0.REG_TYPE | BYTE | BYTE | 0
379 | VAR | CONFIG0.RES0.INSTANCE0.MODBUS_WRITE_ARRAY0.START_ADDR | CONFIG0.RES0.INSTANCE0.MODBUS_WRITE_ARRAY0.START_ADDR | WORD | WORD | 0
380 | VAR | CONFIG0.RES0.INSTANCE0.MODBUS_WRITE_ARRAY0.LENGTH | CONFIG0.RES0.INSTANCE0.MODBUS_WRITE_ARRAY0.LENGTH | BYTE | BYTE | 0
381 | VAR | CONFIG0.RES0.INSTANCE0.MODBUS_WRITE_ARRAY0.COILS.value.table[0] | CONFIG0.RES0.INSTANCE0.MODBUS_WRITE_ARRAY0.COILS.value.table[0] | BOOL | BOOL | 0
382 | VAR | CONFIG0.RES0.INSTANCE0.MODBUS_WRITE_ARRAY0.COILS.value.table[1] | CONFIG0.RES0.INSTANCE0.MODBUS_WRITE_ARRAY0.COILS.value.table[1] | BOOL | BOOL | 0
383 | VAR | CONFIG0.RES0.INSTANCE0.MODBUS_WRITE_ARRAY0.COILS.value.table[2] | CONFIG0.RES0.INSTANCE0.MODBUS_WRITE_ARRAY0.COILS.value.table[2] | BOOL | BOOL | 0
384 | VAR | CONFIG0.RES0.INSTANCE0.MODBUS_WRITE_ARRAY0.COILS.value.table[3] | CONFIG0.RES0.INSTANCE0.MODBUS_WRITE_ARRAY0.COILS.value.table[3] | BOOL | BOOL | 0
385 | VAR | CONFIG0.RES0.INSTANCE0.MODBUS_WRITE_ARRAY0.COILS.value.table[4] | CONFIG0.RES0.INSTANCE0.MODBUS_WRITE_ARRAY0.COILS.value.table[4] | BOOL | BOOL | 0
386 | VAR | CONFIG0.RES0.INSTANCE0.MODBUS_WRITE_ARRAY0.COILS.value.table[5] | CONFIG0.RES0.INSTANCE0.MODBUS_WRITE_ARRAY0.COILS.value.table[5] | BOOL | BOOL | 0
387 | VAR | CONFIG0.RES0.INSTANCE0.MODBUS_WRITE_ARRAY0.COILS.value.table[6] | CONFIG0.RES0.INSTANCE0.MODBUS_WRITE_ARRAY0.COILS.value.table[6] | BOOL | BOOL | 0
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
508 | VAR | CONFIG0.RES0.INSTANCE0.MODBUS_WRITE_ARRAY1.REGS.value.table[20] | CONFIG0.RES0.INSTANCE0.MODBUS_WRITE_ARRAY1.REGS.value.table[20] | INT | INT | 0
509 | VAR | CONFIG0.RES0.INSTANCE0.MODBUS_WRITE_ARRAY1.REGS.value.table[21] | CONFIG0.RES0.INSTANCE0.MODBUS_WRITE_ARRAY1.REGS.value.table[21] | INT | INT | 0
510 | VAR | CONFIG0.RES0.INSTANCE0.MODBUS_WRITE_ARRAY1.REGS.value.table[22] | CONFIG0.RES0.INSTANCE0.MODBUS_WRITE_ARRAY1.REGS.value.table[22] | INT | INT | 0
511 | VAR | CONFIG0.RES0.INSTANCE0.MODBUS_WRITE_ARRAY1.REGS.value.table[23] | CONFIG0.RES0.INSTANCE0.MODBUS_WRITE_ARRAY1.REGS.value.table[23] | INT | INT | 0
512 | VAR | CONFIG0.RES0.INSTANCE0.MODBUS_WRITE_ARRAY1.REGS.value.table[24] | CONFIG0.RES0.INSTANCE0.MODBUS_WRITE_ARRAY1.REGS.value.table[24] | INT | INT | 0
513 | VAR | CONFIG0.RES0.INSTANCE0.MODBUS_WRITE_ARRAY1.REGS.value.table[25] | CONFIG0.RES0.INSTANCE0.MODBUS_WRITE_ARRAY1.REGS.value.table[25] | INT | INT | 0
514 | VAR | CONFIG0.RES0.INSTANCE0.MODBUS_WRITE_ARRAY1.REGS.value.table[26] | CONFIG0.RES0.INSTANCE0.MODBUS_WRITE_ARRAY1.REGS.value.table[26] | INT | INT | 0
515 | VAR | CONFIG0.RES0.INSTANCE0.MODBUS_WRITE_ARRAY1.REGS.value.table[27] | CONFIG0.RES0.INSTANCE0.MODBUS_WRITE_ARRAY1.REGS.value.table[27] | INT | INT | 0
516 | VAR | CONFIG0.RES0.INSTANCE0.MODBUS_WRITE_ARRAY1.REGS.value.table[28] | CONFIG0.RES0.INSTANCE0.MODBUS_WRITE_ARRAY1.REGS.value.table[28] | INT | INT | 0
517 | VAR | CONFIG0.RES0.INSTANCE0.MODBUS_WRITE_ARRAY1.REGS.value.table[29] | CONFIG0.RES0.INSTANCE0.MODBUS_WRITE_ARRAY1.REGS.value.table[29] | INT | INT | 0
518 | VAR | CONFIG0.RES0.INSTANCE0.MODBUS_WRITE_ARRAY1.REGS.value.table[30] | CONFIG0.RES0.INSTANCE0.MODBUS_WRITE_ARRAY1.REGS.value.table[30] | INT | INT | 0
519 | VAR | CONFIG0.RES0.INSTANCE0.MODBUS_WRITE_ARRAY1.REGS.value.table[31] | CONFIG0.RES0.INSTANCE0.MODBUS_WRITE_ARRAY1.REGS.value.table[31] | INT | INT | 0
520 | VAR | CONFIG0.RES0.INSTANCE0.MODBUS_WRITE_ARRAY1.DONE | CONFIG0.RES0.INSTANCE0.MODBUS_WRITE_ARRAY1.DONE | BOOL | BOOL | 0
521 | VAR | CONFIG0.RES0.INSTANCE0.MODBUS_WRITE_ARRAY1.ERROR | CONFIG0.RES0.INSTANCE0.MODBUS_WRITE_ARRAY1.ERROR | BOOL | BOOL | 0
522 | VAR | CONFIG0.RES0.INSTANCE0.MODBUS_WRITE_ARRAY1.HASBEENINITIALIZED | CONFIG0.RES0.INSTANCE0.MODBUS_WRITE_ARRAY1.HASBEENINITIALIZED | BOOL | BOOL | 0
523 | VAR | CONFIG0.RES0.INSTANCE0._TMP_REAL_TO_INT5408527_ENO | CONFIG0.RES0.INSTANCE0._TMP_REAL_TO_INT5408527_ENO | BOOL | BOOL | 0
524 | VAR | CONFIG0.RES0.INSTANCE0._TMP_REAL_TO_INT5408527_OUT | CONFIG0.RES0.INSTANCE0._TMP_REAL_TO_INT5408527_OUT | INT | INT | 0
525 | VAR | CONFIG0.RES0.INSTANCE0._TMP_REAL_TO_INT3098114_ENO | CONFIG0.RES0.INSTANCE0._TMP_REAL_TO_INT3098114_ENO | BOOL | BOOL | 0
526 | VAR | CONFIG0.RES0.INSTANCE0._TMP_REAL_TO_INT3098114_OUT | CONFIG0.RES0.INSTANCE0._TMP_REAL_TO_INT3098114_OUT | INT | INT | 0
527 | FB | CONFIG0.RES0.INSTANCE1 | CONFIG0.RES0.INSTANCE1 | MODBEE |  | 0
528 | FB | CONFIG0.RES0.INSTANCE1.MODBEE_HW_CONFIG0 | CONFIG0.RES0.INSTANCE1.MODBEE_HW_CONFIG0 | MODBEE_HW_CONFIG |  | 0
529 | VAR | CONFIG0.RES0.INSTANCE1.MODBEE_HW_CONFIG0.EN | CONFIG0.RES0.INSTANCE1.MODBEE_HW_CONFIG0.EN | BOOL | BOOL | 0
530 | VAR | CONFIG0.RES0.INSTANCE1.MODBEE_HW_CONFIG0.ENO | CONFIG0.RES0.INSTANCE1.MODBEE_HW_CONFIG0.ENO | BOOL | BOOL | 0
531 | VAR | CONFIG0.RES0.INSTANCE1.MODBEE_HW_CONFIG0.HASBEENINITIALIZED | CONFIG0.RES0.INSTANCE1.MODBEE_HW_CONFIG0.HASBEENINITIALIZED | BOOL | BOOL | 0
// Ticktime
1000000
