mod-bee/modbee-node-uio/openPLC/projects/Modbee-MB-Master/build/ESP32-S3/src/VARIABLES.csv

// Programs
0 | CONFIG0.RES0.INSTANCE0 | MAIN
1 | CONFIG0.RES0.INSTANCE1 | MODBEE
// Variables
0 | FB | CONFIG0.RES0.INSTANCE0 | CONFIG0.RES0.INSTANCE0 | MAIN |  | 0
1 | FB | CONFIG0.RES0.INSTANCE0.MODBEE_HW_INPUTS0 | CONFIG0.RES0.INSTANCE0.MODBEE_HW_INPUTS0 | MODBEE_HW_INPUTS |  | 0
2 | VAR | CONFIG0.RES0.INSTANCE0.MODBEE_HW_INPUTS0.EN | CONFIG0.RES0.INSTANCE0.MODBEE_HW_INPUTS0.EN | BOOL | BOOL | 0
3 | VAR | CONFIG0.RES0.INSTANCE0.MODBEE_HW_INPUTS0.ENO | CONFIG0.RES0.INSTANCE0.MODBEE_HW_INPUTS0.ENO | BOOL | BOOL | 0
4 | VAR | CONFIG0.RES0.INSTANCE0.MODBEE_HW_INPUTS0.DX01 | CONFIG0.RES0.INSTANCE0.MODBEE_HW_INPUTS0.DX01 | BOOL | BOOL | 0
5 | VAR | CONFIG0.RES0.INSTANCE0.MODBEE_HW_INPUTS0.DX02 | CONFIG0.RES0.INSTANCE0.MODBEE_HW_INPUTS0.DX02 | BOOL | BOOL | 0
6 | VAR | CONFIG0.RES0.INSTANCE0.MODBEE_HW_INPUTS0.DX03 | CONFIG0.RES0.INSTANCE0.MODBEE_HW_INPUTS0.DX03 | BOOL | BOOL | 0
7 | VAR | CONFIG0.RES0.INSTANCE0.MODBEE_HW_INPUTS0.DX04 | CONFIG0.RES0.INSTANCE0.MODBEE_HW_INPUTS0.DX04 | BOOL | BOOL | 0
8 | VAR | CONFIG0.RES0.INSTANCE0.MODBEE_HW_INPUTS0.DX05 | CONFIG0.RES0.INSTANCE0.MODBEE_HW_INPUTS0.DX05 | BOOL | BOOL | 0
9 | VAR | CONFIG0.RES0.INSTANCE0.MODBEE_HW_INPUTS0.DX06 | CONFIG0.RES0.INSTANCE0.MODBEE_HW_INPUTS0.DX06 | BOOL | BOOL | 0
10 | VAR | CONFIG0.RES0.INSTANCE0.MODBEE_HW_INPUTS0.DX07 | CONFIG0.RES0.INSTANCE0.MODBEE_HW_INPUTS0.DX07 | BOOL | BOOL | 0
11 | VAR | CONFIG0.RES0.INSTANCE0.MODBEE_HW_INPUTS0.DX08 | CONFIG0.RES0.INSTANCE0.MODBEE_HW_INPUTS0.DX08 | BOOL | BOOL | 0
12 | VAR | CONFIG0.RES0.INSTANCE0.MODBEE_HW_INPUTS0.AX01_SCALED | CONFIG0.RES0.INSTANCE0.MODBEE_HW_INPUTS0.AX01_SCALED | REAL | REAL | 0
13 | VAR | CONFIG0.RES0.INSTANCE0.MODBEE_HW_INPUTS0.AX02_SCALED | CONFIG0.RES0.INSTANCE0.MODBEE_HW_INPUTS0.AX02_SCALED | REAL | REAL | 0
14 | VAR | CONFIG0.RES0.INSTANCE0.MODBEE_HW_INPUTS0.AX03_SCALED | CONFIG0.RES0.INSTANCE0.MODBEE_HW_INPUTS0.AX03_SCALED | REAL | REAL | 0
15 | VAR | CONFIG0.RES0.INSTANCE0.MODBEE_HW_INPUTS0.AX04_SCALED | CONFIG0.RES0.INSTANCE0.MODBEE_HW_INPUTS0.AX04_SCALED | REAL | REAL | 0
16 | VAR | CONFIG0.RES0.INSTANCE0.MODBEE_HW_INPUTS0.HASBEENINITIALIZED | CONFIG0.RES0.INSTANCE0.MODBEE_HW_INPUTS0.HASBEENINITIALIZED | BOOL | BOOL | 0
17 | FB | CONFIG0.RES0.INSTANCE0.MODBEE_HW_OUTPUTS0 | CONFIG0.RES0.INSTANCE0.MODBEE_HW_OUTPUTS0 | MODBEE_HW_OUTPUTS |  | 0
18 | VAR | CONFIG0.RES0.INSTANCE0.MODBEE_HW_OUTPUTS0.EN | CONFIG0.RES0.INSTANCE0.MODBEE_HW_OUTPUTS0.EN | BOOL | BOOL | 0
19 | VAR | CONFIG0.RES0.INSTANCE0.MODBEE_HW_OUTPUTS0.ENO | CONFIG0.RES0.INSTANCE0.MODBEE_HW_OUTPUTS0.ENO | BOOL | BOOL | 0
20 | VAR | CONFIG0.RES0.INSTANCE0.MODBEE_HW_OUTPUTS0.DY01 | CONFIG0.RES0.INSTANCE0.MODBEE_HW_OUTPUTS0.DY01 | BOOL | BOOL | 0
21 | VAR | CONFIG0.RES0.INSTANCE0.MODBEE_HW_OUTPUTS0.DY02 | CONFIG0.RES0.INSTANCE0.MODBEE_HW_OUTPUTS0.DY02 | BOOL | BOOL | 0
22 | VAR | CONFIG0.RES0.INSTANCE0.MODBEE_HW_OUTPUTS0.DY03 | CONFIG0.RES0.INSTANCE0.MODBEE_HW_OUTPUTS0.DY03 | BOOL | BOOL | 0
23 | VAR | CONFIG0.RES0.INSTANCE0.MODBEE_HW_OUTPUTS0.DY04 | CONFIG0.RES0.INSTANCE0.MODBEE_HW_OUTPUTS0.DY04 | BOOL | BOOL | 0
24 | VAR | CONFIG0.RES0.INSTANCE0.MODBEE_HW_OUTPUTS0.DY05 | CONFIG0.RES0.INSTANCE0.MODBEE_HW_OUTPUTS0.DY05 | BOOL | BOOL | 0
25 | VAR | CONFIG0.RES0.INSTANCE0.MODBEE_HW_OUTPUTS0.DY06 | CONFIG0.RES0.INSTANCE0.MODBEE_HW_OUTPUTS0.DY06 | BOOL | BOOL | 0
26 | VAR | CONFIG0.RES0.INSTANCE0.MODBEE_HW_OUTPUTS0.DY07 | CONFIG0.RES0.INSTANCE0.MODBEE_HW_OUTPUTS0.DY07 | BOOL | BOOL | 0
27 | VAR | CONFIG0.RES0.INSTANCE0.MODBEE_HW_OUTPUTS0.DY08 | CONFIG0.RES0.INSTANCE0.MODBEE_HW_OUTPUTS0.DY08 | BOOL | BOOL | 0
28 | VAR | CONFIG0.RES0.INSTANCE0.MODBEE_HW_OUTPUTS0.AY01_SCALED | CONFIG0.RES0.INSTANCE0.MODBEE_HW_OUTPUTS0.AY01_SCALED | REAL | REAL | 0
29 | VAR | CONFIG0.RES0.INSTANCE0.MODBEE_HW_OUTPUTS0.AY02_SCALED | CONFIG0.RES0.INSTANCE0.MODBEE_HW_OUTPUTS0.AY02_SCALED | REAL | REAL | 0
30 | VAR | CONFIG0.RES0.INSTANCE0.MODBEE_HW_OUTPUTS0.HASBEENINITIALIZED | CONFIG0.RES0.INSTANCE0.MODBEE_HW_OUTPUTS0.HASBEENINITIALIZED | BOOL | BOOL | 0
31 | VAR | CONFIG0.RES0.INSTANCE0.START | CONFIG0.RES0.INSTANCE0.START | BOOL | BOOL | 0
32 | VAR | CONFIG0.RES0.INSTANCE0.STOP | CONFIG0.RES0.INSTANCE0.STOP | BOOL | BOOL | 0
33 | VAR | CONFIG0.RES0.INSTANCE0.RUN | CONFIG0.RES0.INSTANCE0.RUN | BOOL | BOOL | 0
34 | FB | CONFIG0.RES0.INSTANCE0.MODBUS_WRITE0 | CONFIG0.RES0.INSTANCE0.MODBUS_WRITE0 | MODBUS_WRITE |  | 0
35 | VAR | CONFIG0.RES0.INSTANCE0.MODBUS_WRITE0.EN | CONFIG0.RES0.INSTANCE0.MODBUS_WRITE0.EN | BOOL | BOOL | 0
36 | VAR | CONFIG0.RES0.INSTANCE0.MODBUS_WRITE0.ENO | CONFIG0.RES0.INSTANCE0.MODBUS_WRITE0.ENO | BOOL | BOOL | 0
37 | VAR | CONFIG0.RES0.INSTANCE0.MODBUS_WRITE0.REQ | CONFIG0.RES0.INSTANCE0.MODBUS_WRITE0.REQ | BOOL | BOOL | 0
38 | VAR | CONFIG0.RES0.INSTANCE0.MODBUS_WRITE0.SLAVE_ID | CONFIG0.RES0.INSTANCE0.MODBUS_WRITE0.SLAVE_ID | BYTE | BYTE | 0
39 | VAR | CONFIG0.RES0.INSTANCE0.MODBUS_WRITE0.REG_TYPE | CONFIG0.RES0.INSTANCE0.MODBUS_WRITE0.REG_TYPE | BYTE | BYTE | 0
40 | VAR | CONFIG0.RES0.INSTANCE0.MODBUS_WRITE0.START_ADDR | CONFIG0.RES0.INSTANCE0.MODBUS_WRITE0.START_ADDR | WORD | WORD | 0
41 | VAR | CONFIG0.RES0.INSTANCE0.MODBUS_WRITE0.LENGTH | CONFIG0.RES0.INSTANCE0.MODBUS_WRITE0.LENGTH | BYTE | BYTE | 0
42 | VAR | CONFIG0.RES0.INSTANCE0.MODBUS_WRITE0.COIL_01 | CONFIG0.RES0.INSTANCE0.MODBUS_WRITE0.COIL_01 | BOOL | BOOL | 0
43 | VAR | CONFIG0.RES0.INSTANCE0.MODBUS_WRITE0.COIL_02 | CONFIG0.RES0.INSTANCE0.MODBUS_WRITE0.COIL_02 | BOOL | BOOL | 0
44 | VAR | CONFIG0.RES0.INSTANCE0.MODBUS_WRITE0.COIL_03 | CONFIG0.RES0.INSTANCE0.MODBUS_WRITE0.COIL_03 | BOOL | BOOL | 0
45 | VAR | CONFIG0.RES0.INSTANCE0.MODBUS_WRITE0.COIL_04 | CONFIG0.RES0.INSTANCE0.MODBUS_WRITE0.COIL_04 | BOOL | BOOL | 0
46 | VAR | CONFIG0.RES0.INSTANCE0.MODBUS_WRITE0.COIL_05 | CONFIG0.RES0.INSTANCE0.MODBUS_WRITE0.COIL_05 | BOOL | BOOL | 0
47 | VAR | CONFIG0.RES0.INSTANCE0.MODBUS_WRITE0.COIL_06 | CONFIG0.RES0.INSTANCE0.MODBUS_WRITE0.COIL_06 | BOOL | BOOL | 0
48 | VAR | CONFIG0.RES0.INSTANCE0.MODBUS_WRITE0.COIL_07 | CONFIG0.RES0.INSTANCE0.MODBUS_WRITE0.COIL_07 | BOOL | BOOL | 0
49 | VAR | CONFIG0.RES0.INSTANCE0.MODBUS_WRITE0.COIL_08 | CONFIG0.RES0.INSTANCE0.MODBUS_WRITE0.COIL_08 | BOOL | BOOL | 0
50 | VAR | CONFIG0.RES0.INSTANCE0.MODBUS_WRITE0.REG_01 | CONFIG0.RES0.INSTANCE0.MODBUS_WRITE0.REG_01 | INT | INT | 0
51 | VAR | CONFIG0.RES0.INSTANCE0.MODBUS_WRITE0.REG_02 | CONFIG0.RES0.INSTANCE0.MODBUS_WRITE0.REG_02 | INT | INT | 0
52 | VAR | CONFIG0.RES0.INSTANCE0.MODBUS_WRITE0.REG_03 | CONFIG0.RES0.INSTANCE0.MODBUS_WRITE0.REG_03 | INT | INT | 0
53 | VAR | CONFIG0.RES0.INSTANCE0.MODBUS_WRITE0.REG_04 | CONFIG0.RES0.INSTANCE0.MODBUS_WRITE0.REG_04 | INT | INT | 0
54 | VAR | CONFIG0.RES0.INSTANCE0.MODBUS_WRITE0.REG_05 | CONFIG0.RES0.INSTANCE0.MODBUS_WRITE0.REG_05 | INT | INT | 0
55 | VAR | CONFIG0.RES0.INSTANCE0.MODBUS_WRITE0.REG_06 | CONFIG0.RES0.INSTANCE0.MODBUS_WRITE0.REG_06 | INT | INT | 0
56 | VAR | CONFIG0.RES0.INSTANCE0.MODBUS_WRITE0.REG_07 | CONFIG0.RES0.INSTANCE0.MODBUS_WRITE0.REG_07 | INT | INT | 0
57 | VAR | CONFIG0.RES0.INSTANCE0.MODBUS_WRITE0.REG_08 | CONFIG0.RES0.INSTANCE0.MODBUS_WRITE0.REG_08 | INT | INT | 0
58 | VAR | CONFIG0.RES0.INSTANCE0.MODBUS_WRITE0.DONE | CONFIG0.RES0.INSTANCE0.MODBUS_WRITE0.DONE | BOOL | BOOL | 0
59 | VAR | CONFIG0.RES0.INSTANCE0.MODBUS_WRITE0.ERROR | CONFIG0.RES0.INSTANCE0.MODBUS_WRITE0.ERROR | BOOL | BOOL | 0
60 | VAR | CONFIG0.RES0.INSTANCE0.MODBUS_WRITE0.HASBEENINITIALIZED | CONFIG0.RES0.INSTANCE0.MODBUS_WRITE0.HASBEENINITIALIZED | BOOL | BOOL | 0
61 | VAR | CONFIG0.RES0.INSTANCE0.MB_SLAVE_DO01 | CONFIG0.RES0.INSTANCE0.MB_SLAVE_DO01 | BOOL | BOOL | 0
62 | VAR | CONFIG0.RES0.INSTANCE0.MB_SLAVE_DO02 | CONFIG0.RES0.INSTANCE0.MB_SLAVE_DO02 | BOOL | BOOL | 0
63 | VAR | CONFIG0.RES0.INSTANCE0.MB_SLAVE_DO03 | CONFIG0.RES0.INSTANCE0.MB_SLAVE_DO03 | BOOL | BOOL | 0
64 | VAR | CONFIG0.RES0.INSTANCE0.MB_SLAVE_DO04 | CONFIG0.RES0.INSTANCE0.MB_SLAVE_DO04 | BOOL | BOOL | 0
65 | VAR | CONFIG0.RES0.INSTANCE0.MB_SLAVE_DO05 | CONFIG0.RES0.INSTANCE0.MB_SLAVE_DO05 | BOOL | BOOL | 0
66 | VAR | CONFIG0.RES0.INSTANCE0.MB_SLAVE_DO06 | CONFIG0.RES0.INSTANCE0.MB_SLAVE_DO06 | BOOL | BOOL | 0
67 | VAR | CONFIG0.RES0.INSTANCE0.MB_SLAVE_DO07 | CONFIG0.RES0.INSTANCE0.MB_SLAVE_DO07 | BOOL | BOOL | 0
68 | VAR | CONFIG0.RES0.INSTANCE0.MB_SLAVE_DO08 | CONFIG0.RES0.INSTANCE0.MB_SLAVE_DO08 | BOOL | BOOL | 0
69 | FB | CONFIG0.RES0.INSTANCE0.MODBUS_READ0 | CONFIG0.RES0.INSTANCE0.MODBUS_READ0 | MODBUS_READ |  | 0
70 | VAR | CONFIG0.RES0.INSTANCE0.MODBUS_READ0.EN | CONFIG0.RES0.INSTANCE0.MODBUS_READ0.EN | BOOL | BOOL | 0
71 | VAR | CONFIG0.RES0.INSTANCE0.MODBUS_READ0.ENO | CONFIG0.RES0.INSTANCE0.MODBUS_READ0.ENO | BOOL | BOOL | 0
72 | VAR | CONFIG0.RES0.INSTANCE0.MODBUS_READ0.REQ | CONFIG0.RES0.INSTANCE0.MODBUS_READ0.REQ | BOOL | BOOL | 0
73 | VAR | CONFIG0.RES0.INSTANCE0.MODBUS_READ0.SLAVE_ID | CONFIG0.RES0.INSTANCE0.MODBUS_READ0.SLAVE_ID | BYTE | BYTE | 0
74 | VAR | CONFIG0.RES0.INSTANCE0.MODBUS_READ0.REG_TYPE | CONFIG0.RES0.INSTANCE0.MODBUS_READ0.REG_TYPE | BYTE | BYTE | 0
75 | VAR | CONFIG0.RES0.INSTANCE0.MODBUS_READ0.START_ADDR | CONFIG0.RES0.INSTANCE0.MODBUS_READ0.START_ADDR | WORD | WORD | 0
76 | VAR | CONFIG0.RES0.INSTANCE0.MODBUS_READ0.LENGTH | CONFIG0.RES0.INSTANCE0.MODBUS_READ0.LENGTH | BYTE | BYTE | 0
77 | VAR | CONFIG0.RES0.INSTANCE0.MODBUS_READ0.DONE | CONFIG0.RES0.INSTANCE0.MODBUS_READ0.DONE | BOOL | BOOL | 0
78 | VAR | CONFIG0.RES0.INSTANCE0.MODBUS_READ0.ERROR | CONFIG0.RES0.INSTANCE0.MODBUS_READ0.ERROR | BOOL | BOOL | 0
79 | VAR | CONFIG0.RES0.INSTANCE0.MODBUS_READ0.COIL_01 | CONFIG0.RES0.INSTANCE0.MODBUS_READ0.COIL_01 | BOOL | BOOL | 0
80 | VAR | CONFIG0.RES0.INSTANCE0.MODBUS_READ0.COIL_02 | CONFIG0.RES0.INSTANCE0.MODBUS_READ0.COIL_02 | BOOL | BOOL | 0
81 | VAR | CONFIG0.RES0.INSTANCE0.MODBUS_READ0.COIL_03 | CONFIG0.RES0.INSTANCE0.MODBUS_READ0.COIL_03 | BOOL | BOOL | 0
82 | VAR | CONFIG0.RES0.INSTANCE0.MODBUS_READ0.COIL_04 | CONFIG0.RES0.INSTANCE0.MODBUS_READ0.COIL_04 | BOOL | BOOL | 0
83 | VAR | CONFIG0.RES0.INSTANCE0.MODBUS_READ0.COIL_05 | CONFIG0.RES0.INSTANCE0.MODBUS_READ0.COIL_05 | BOOL | BOOL | 0
84 | VAR | CONFIG0.RES0.INSTANCE0.MODBUS_READ0.COIL_06 | CONFIG0.RES0.INSTANCE0.MODBUS_READ0.COIL_06 | BOOL | BOOL | 0
85 | VAR | CONFIG0.RES0.INSTANCE0.MODBUS_READ0.COIL_07 | CONFIG0.RES0.INSTANCE0.MODBUS_READ0.COIL_07 | BOOL | BOOL | 0
86 | VAR | CONFIG0.RES0.INSTANCE0.MODBUS_READ0.COIL_08 | CONFIG0.RES0.INSTANCE0.MODBUS_READ0.COIL_08 | BOOL | BOOL | 0
87 | VAR | CONFIG0.RES0.INSTANCE0.MODBUS_READ0.REG_01 | CONFIG0.RES0.INSTANCE0.MODBUS_READ0.REG_01 | INT | INT | 0
88 | VAR | CONFIG0.RES0.INSTANCE0.MODBUS_READ0.REG_02 | CONFIG0.RES0.INSTANCE0.MODBUS_READ0.REG_02 | INT | INT | 0
89 | VAR | CONFIG0.RES0.INSTANCE0.MODBUS_READ0.REG_03 | CONFIG0.RES0.INSTANCE0.MODBUS_READ0.REG_03 | INT | INT | 0
90 | VAR | CONFIG0.RES0.INSTANCE0.MODBUS_READ0.REG_04 | CONFIG0.RES0.INSTANCE0.MODBUS_READ0.REG_04 | INT | INT | 0
91 | VAR | CONFIG0.RES0.INSTANCE0.MODBUS_READ0.REG_05 | CONFIG0.RES0.INSTANCE0.MODBUS_READ0.REG_05 | INT | INT | 0
92 | VAR | CONFIG0.RES0.INSTANCE0.MODBUS_READ0.REG_06 | CONFIG0.RES0.INSTANCE0.MODBUS_READ0.REG_06 | INT | INT | 0
93 | VAR | CONFIG0.RES0.INSTANCE0.MODBUS_READ0.REG_07 | CONFIG0.RES0.INSTANCE0.MODBUS_READ0.REG_07 | INT | INT | 0
94 | VAR | CONFIG0.RES0.INSTANCE0.MODBUS_READ0.REG_08 | CONFIG0.RES0.INSTANCE0.MODBUS_READ0.REG_08 | INT | INT | 0
95 | VAR | CONFIG0.RES0.INSTANCE0.MODBUS_READ0.HASBEENINITIALIZED | CONFIG0.RES0.INSTANCE0.MODBUS_READ0.HASBEENINITIALIZED | BOOL | BOOL | 0
96 | VAR | CONFIG0.RES0.INSTANCE0.MB_SLAVE_DI01 | CONFIG0.RES0.INSTANCE0.MB_SLAVE_DI01 | BOOL | BOOL | 0
97 | VAR | CONFIG0.RES0.INSTANCE0.MB_SLAVE_DI02 | CONFIG0.RES0.INSTANCE0.MB_SLAVE_DI02 | BOOL | BOOL | 0
98 | VAR | CONFIG0.RES0.INSTANCE0.MB_SLAVE_DI03 | CONFIG0.RES0.INSTANCE0.MB_SLAVE_DI03 | BOOL | BOOL | 0
99 | VAR | CONFIG0.RES0.INSTANCE0.MB_SLAVE_DI05 | CONFIG0.RES0.INSTANCE0.MB_SLAVE_DI05 | BOOL | BOOL | 0
100 | VAR | CONFIG0.RES0.INSTANCE0.MB_SLAVE_DI04 | CONFIG0.RES0.INSTANCE0.MB_SLAVE_DI04 | BOOL | BOOL | 0
101 | VAR | CONFIG0.RES0.INSTANCE0.MB_SLAVE_DI06 | CONFIG0.RES0.INSTANCE0.MB_SLAVE_DI06 | BOOL | BOOL | 0
102 | VAR | CONFIG0.RES0.INSTANCE0.MB_SLAVE_DI07 | CONFIG0.RES0.INSTANCE0.MB_SLAVE_DI07 | BOOL | BOOL | 0
103 | VAR | CONFIG0.RES0.INSTANCE0.MB_SLAVE_DI08 | CONFIG0.RES0.INSTANCE0.MB_SLAVE_DI08 | BOOL | BOOL | 0
104 | VAR | CONFIG0.RES0.INSTANCE0.MB_WRITE_COILS_DONE | CONFIG0.RES0.INSTANCE0.MB_WRITE_COILS_DONE | BOOL | BOOL | 0
105 | VAR | CONFIG0.RES0.INSTANCE0.MB_READ_COILS_DONE | CONFIG0.RES0.INSTANCE0.MB_READ_COILS_DONE | BOOL | BOOL | 0
106 | FB | CONFIG0.RES0.INSTANCE0.TON0 | CONFIG0.RES0.INSTANCE0.TON0 | TON |  | 0
107 | VAR | CONFIG0.RES0.INSTANCE0.TON0.EN | CONFIG0.RES0.INSTANCE0.TON0.EN | BOOL | BOOL | 0
108 | VAR | CONFIG0.RES0.INSTANCE0.TON0.ENO | CONFIG0.RES0.INSTANCE0.TON0.ENO | BOOL | BOOL | 0
109 | VAR | CONFIG0.RES0.INSTANCE0.TON0.IN | CONFIG0.RES0.INSTANCE0.TON0.IN | BOOL | BOOL | 0
110 | VAR | CONFIG0.RES0.INSTANCE0.TON0.PT | CONFIG0.RES0.INSTANCE0.TON0.PT | TIME | TIME | 0
111 | VAR | CONFIG0.RES0.INSTANCE0.TON0.Q | CONFIG0.RES0.INSTANCE0.TON0.Q | BOOL | BOOL | 0
112 | VAR | CONFIG0.RES0.INSTANCE0.TON0.ET | CONFIG0.RES0.INSTANCE0.TON0.ET | TIME | TIME | 0
113 | VAR | CONFIG0.RES0.INSTANCE0.TON0.STATE | CONFIG0.RES0.INSTANCE0.TON0.STATE | SINT | SINT | 0
114 | VAR | CONFIG0.RES0.INSTANCE0.TON0.PREV_IN | CONFIG0.RES0.INSTANCE0.TON0.PREV_IN | BOOL | BOOL | 0
115 | VAR | CONFIG0.RES0.INSTANCE0.TON0.CURRENT_TIME | CONFIG0.RES0.INSTANCE0.TON0.CURRENT_TIME | TIME | TIME | 0
116 | VAR | CONFIG0.RES0.INSTANCE0.TON0.START_TIME | CONFIG0.RES0.INSTANCE0.TON0.START_TIME | TIME | TIME | 0
117 | FB | CONFIG0.RES0.INSTANCE0.TON1 | CONFIG0.RES0.INSTANCE0.TON1 | TON |  | 0
118 | VAR | CONFIG0.RES0.INSTANCE0.TON1.EN | CONFIG0.RES0.INSTANCE0.TON1.EN | BOOL | BOOL | 0
119 | VAR | CONFIG0.RES0.INSTANCE0.TON1.ENO | CONFIG0.RES0.INSTANCE0.TON1.ENO | BOOL | BOOL | 0
120 | VAR | CONFIG0.RES0.INSTANCE0.TON1.IN | CONFIG0.RES0.INSTANCE0.TON1.IN | BOOL | BOOL | 0
121 | VAR | CONFIG0.RES0.INSTANCE0.TON1.PT | CONFIG0.RES0.INSTANCE0.TON1.PT | TIME | TIME | 0
122 | VAR | CONFIG0.RES0.INSTANCE0.TON1.Q | CONFIG0.RES0.INSTANCE0.TON1.Q | BOOL | BOOL | 0
123 | VAR | CONFIG0.RES0.INSTANCE0.TON1.ET | CONFIG0.RES0.INSTANCE0.TON1.ET | TIME | TIME | 0
124 | VAR | CONFIG0.RES0.INSTANCE0.TON1.STATE | CONFIG0.RES0.INSTANCE0.TON1.STATE | SINT | SINT | 0
125 | VAR | CONFIG0.RES0.INSTANCE0.TON1.PREV_IN | CONFIG0.RES0.INSTANCE0.TON1.PREV_IN | BOOL | BOOL | 0
126 | VAR | CONFIG0.RES0.INSTANCE0.TON1.CURRENT_TIME | CONFIG0.RES0.INSTANCE0.TON1.CURRENT_TIME | TIME | TIME | 0
127 | VAR | CONFIG0.RES0.INSTANCE0.TON1.START_TIME | CONFIG0.RES0.INSTANCE0.TON1.START_TIME | TIME | TIME | 0
128 | VAR | CONFIG0.RES0.INSTANCE0.TON1_DONE | CONFIG0.RES0.INSTANCE0.TON1_DONE | BOOL | BOOL | 0
129 | VAR | CONFIG0.RES0.INSTANCE0.TON0_DONE | CONFIG0.RES0.INSTANCE0.TON0_DONE | BOOL | BOOL | 0
130 | FB | CONFIG0.RES0.INSTANCE0.MODBUS_READ1 | CONFIG0.RES0.INSTANCE0.MODBUS_READ1 | MODBUS_READ |  | 0
131 | VAR | CONFIG0.RES0.INSTANCE0.MODBUS_READ1.EN | CONFIG0.RES0.INSTANCE0.MODBUS_READ1.EN | BOOL | BOOL | 0
132 | VAR | CONFIG0.RES0.INSTANCE0.MODBUS_READ1.ENO | CONFIG0.RES0.INSTANCE0.MODBUS_READ1.ENO | BOOL | BOOL | 0
133 | VAR | CONFIG0.RES0.INSTANCE0.MODBUS_READ1.REQ | CONFIG0.RES0.INSTANCE0.MODBUS_READ1.REQ | BOOL | BOOL | 0
134 | VAR | CONFIG0.RES0.INSTANCE0.MODBUS_READ1.SLAVE_ID | CONFIG0.RES0.INSTANCE0.MODBUS_READ1.SLAVE_ID | BYTE | BYTE | 0
135 | VAR | CONFIG0.RES0.INSTANCE0.MODBUS_READ1.REG_TYPE | CONFIG0.RES0.INSTANCE0.MODBUS_READ1.REG_TYPE | BYTE | BYTE | 0
136 | VAR | CONFIG0.RES0.INSTANCE0.MODBUS_READ1.START_ADDR | CONFIG0.RES0.INSTANCE0.MODBUS_READ1.START_ADDR | WORD | WORD | 0
137 | VAR | CONFIG0.RES0.INSTANCE0.MODBUS_READ1.LENGTH | CONFIG0.RES0.INSTANCE0.MODBUS_READ1.LENGTH | BYTE | BYTE | 0
138 | VAR | CONFIG0.RES0.INSTANCE0.MODBUS_READ1.DONE | CONFIG0.RES0.INSTANCE0.MODBUS_READ1.DONE | BOOL | BOOL | 0
139 | VAR | CONFIG0.RES0.INSTANCE0.MODBUS_READ1.ERROR | CONFIG0.RES0.INSTANCE0.MODBUS_READ1.ERROR | BOOL | BOOL | 0
140 | VAR | CONFIG0.RES0.INSTANCE0.MODBUS_READ1.COIL_01 | CONFIG0.RES0.INSTANCE0.MODBUS_READ1.COIL_01 | BOOL | BOOL | 0
141 | VAR | CONFIG0.RES0.INSTANCE0.MODBUS_READ1.COIL_02 | CONFIG0.RES0.INSTANCE0.MODBUS_READ1.COIL_02 | BOOL | BOOL | 0
142 | VAR | CONFIG0.RES0.INSTANCE0.MODBUS_READ1.COIL_03 | CONFIG0.RES0.INSTANCE0.MODBUS_READ1.COIL_03 | BOOL | BOOL | 0
143 | VAR | CONFIG0.RES0.INSTANCE0.MODBUS_READ1.COIL_04 | CONFIG0.RES0.INSTANCE0.MODBUS_READ1.COIL_04 | BOOL | BOOL | 0
144 | VAR | CONFIG0.RES0.INSTANCE0.MODBUS_READ1.COIL_05 | CONFIG0.RES0.INSTANCE0.MODBUS_READ1.COIL_05 | BOOL | BOOL | 0
145 | VAR | CONFIG0.RES0.INSTANCE0.MODBUS_READ1.COIL_06 | CONFIG0.RES0.INSTANCE0.MODBUS_READ1.COIL_06 | BOOL | BOOL | 0
146 | VAR | CONFIG0.RES0.INSTANCE0.MODBUS_READ1.COIL_07 | CONFIG0.RES0.INSTANCE0.MODBUS_READ1.COIL_07 | BOOL | BOOL | 0
147 | VAR | CONFIG0.RES0.INSTANCE0.MODBUS_READ1.COIL_08 | CONFIG0.RES0.INSTANCE0.MODBUS_READ1.COIL_08 | BOOL | BOOL | 0
148 | VAR | CONFIG0.RES0.INSTANCE0.MODBUS_READ1.REG_01 | CONFIG0.RES0.INSTANCE0.MODBUS_READ1.REG_01 | INT | INT | 0
149 | VAR | CONFIG0.RES0.INSTANCE0.MODBUS_READ1.REG_02 | CONFIG0.RES0.INSTANCE0.MODBUS_READ1.REG_02 | INT | INT | 0
150 | VAR | CONFIG0.RES0.INSTANCE0.MODBUS_READ1.REG_03 | CONFIG0.RES0.INSTANCE0.MODBUS_READ1.REG_03 | INT | INT | 0
151 | VAR | CONFIG0.RES0.INSTANCE0.MODBUS_READ1.REG_04 | CONFIG0.RES0.INSTANCE0.MODBUS_READ1.REG_04 | INT | INT | 0
152 | VAR | CONFIG0.RES0.INSTANCE0.MODBUS_READ1.REG_05 | CONFIG0.RES0.INSTANCE0.MODBUS_READ1.REG_05 | INT | INT | 0
153 | VAR | CONFIG0.RES0.INSTANCE0.MODBUS_READ1.REG_06 | CONFIG0.RES0.INSTANCE0.MODBUS_READ1.REG_06 | INT | INT | 0
154 | VAR | CONFIG0.RES0.INSTANCE0.MODBUS_READ1.REG_07 | CONFIG0.RES0.INSTANCE0.MODBUS_READ1.REG_07 | INT | INT | 0
155 | VAR | CONFIG0.RES0.INSTANCE0.MODBUS_READ1.REG_08 | CONFIG0.RES0.INSTANCE0.MODBUS_READ1.REG_08 | INT | INT | 0
156 | VAR | CONFIG0.RES0.INSTANCE0.MODBUS_READ1.HASBEENINITIALIZED | CONFIG0.RES0.INSTANCE0.MODBUS_READ1.HASBEENINITIALIZED | BOOL | BOOL | 0
157 | VAR | CONFIG0.RES0.INSTANCE0.MB_READ_REGS_DONE | CONFIG0.RES0.INSTANCE0.MB_READ_REGS_DONE | BOOL | BOOL | 0
158 | VAR | CONFIG0.RES0.INSTANCE0.MB_SLAVE_AI01 | CONFIG0.RES0.INSTANCE0.MB_SLAVE_AI01 | INT | INT | 0
159 | VAR | CONFIG0.RES0.INSTANCE0.MB_SLAVE_AI02 | CONFIG0.RES0.INSTANCE0.MB_SLAVE_AI02 | INT | INT | 0
160 | VAR | CONFIG0.RES0.INSTANCE0.MB_SLAVE_AI03 | CONFIG0.RES0.INSTANCE0.MB_SLAVE_AI03 | INT | INT | 0
161 | VAR | CONFIG0.RES0.INSTANCE0.MB_SLAVE_AI04 | CONFIG0.RES0.INSTANCE0.MB_SLAVE_AI04 | INT | INT | 0
162 | FB | CONFIG0.RES0.INSTANCE0.MODBUS_WRITE1 | CONFIG0.RES0.INSTANCE0.MODBUS_WRITE1 | MODBUS_WRITE |  | 0
163 | VAR | CONFIG0.RES0.INSTANCE0.MODBUS_WRITE1.EN | CONFIG0.RES0.INSTANCE0.MODBUS_WRITE1.EN | BOOL | BOOL | 0
164 | VAR | CONFIG0.RES0.INSTANCE0.MODBUS_WRITE1.ENO | CONFIG0.RES0.INSTANCE0.MODBUS_WRITE1.ENO | BOOL | BOOL | 0
165 | VAR | CONFIG0.RES0.INSTANCE0.MODBUS_WRITE1.REQ | CONFIG0.RES0.INSTANCE0.MODBUS_WRITE1.REQ | BOOL | BOOL | 0
166 | VAR | CONFIG0.RES0.INSTANCE0.MODBUS_WRITE1.SLAVE_ID | CONFIG0.RES0.INSTANCE0.MODBUS_WRITE1.SLAVE_ID | BYTE | BYTE | 0
167 | VAR | CONFIG0.RES0.INSTANCE0.MODBUS_WRITE1.REG_TYPE | CONFIG0.RES0.INSTANCE0.MODBUS_WRITE1.REG_TYPE | BYTE | BYTE | 0
168 | VAR | CONFIG0.RES0.INSTANCE0.MODBUS_WRITE1.START_ADDR | CONFIG0.RES0.INSTANCE0.MODBUS_WRITE1.START_ADDR | WORD | WORD | 0
169 | VAR | CONFIG0.RES0.INSTANCE0.MODBUS_WRITE1.LENGTH | CONFIG0.RES0.INSTANCE0.MODBUS_WRITE1.LENGTH | BYTE | BYTE | 0
170 | VAR | CONFIG0.RES0.INSTANCE0.MODBUS_WRITE1.COIL_01 | CONFIG0.RES0.INSTANCE0.MODBUS_WRITE1.COIL_01 | BOOL | BOOL | 0
171 | VAR | CONFIG0.RES0.INSTANCE0.MODBUS_WRITE1.COIL_02 | CONFIG0.RES0.INSTANCE0.MODBUS_WRITE1.COIL_02 | BOOL | BOOL | 0
172 | VAR | CONFIG0.RES0.INSTANCE0.MODBUS_WRITE1.COIL_03 | CONFIG0.RES0.INSTANCE0.MODBUS_WRITE1.COIL_03 | BOOL | BOOL | 0
173 | VAR | CONFIG0.RES0.INSTANCE0.MODBUS_WRITE1.COIL_04 | CONFIG0.RES0.INSTANCE0.MODBUS_WRITE1.COIL_04 | BOOL | BOOL | 0
174 | VAR | CONFIG0.RES0.INSTANCE0.MODBUS_WRITE1.COIL_05 | CONFIG0.RES0.INSTANCE0.MODBUS_WRITE1.COIL_05 | BOOL | BOOL | 0
175 | VAR | CONFIG0.RES0.INSTANCE0.MODBUS_WRITE1.COIL_06 | CONFIG0.RES0.INSTANCE0.MODBUS_WRITE1.COIL_06 | BOOL | BOOL | 0
176 | VAR | CONFIG0.RES0.INSTANCE0.MODBUS_WRITE1.COIL_07 | CONFIG0.RES0.INSTANCE0.MODBUS_WRITE1.COIL_07 | BOOL | BOOL | 0
177 | VAR | CONFIG0.RES0.INSTANCE0.MODBUS_WRITE1.COIL_08 | CONFIG0.RES0.INSTANCE0.MODBUS_WRITE1.COIL_08 | BOOL | BOOL | 0
178 | VAR | CONFIG0.RES0.INSTANCE0.MODBUS_WRITE1.REG_01 | CONFIG0.RES0.INSTANCE0.MODBUS_WRITE1.REG_01 | INT | INT | 0
179 | VAR | CONFIG0.RES0.INSTANCE0.MODBUS_WRITE1.REG_02 | CONFIG0.RES0.INSTANCE0.MODBUS_WRITE1.REG_02 | INT | INT | 0
180 | VAR | CONFIG0.RES0.INSTANCE0.MODBUS_WRITE1.REG_03 | CONFIG0.RES0.INSTANCE0.MODBUS_WRITE1.REG_03 | INT | INT | 0
181 | VAR | CONFIG0.RES0.INSTANCE0.MODBUS_WRITE1.REG_04 | CONFIG0.RES0.INSTANCE0.MODBUS_WRITE1.REG_04 | INT | INT | 0
182 | VAR | CONFIG0.RES0.INSTANCE0.MODBUS_WRITE1.REG_05 | CONFIG0.RES0.INSTANCE0.MODBUS_WRITE1.REG_05 | INT | INT | 0
183 | VAR | CONFIG0.RES0.INSTANCE0.MODBUS_WRITE1.REG_06 | CONFIG0.RES0.INSTANCE0.MODBUS_WRITE1.REG_06 | INT | INT | 0
184 | VAR | CONFIG0.RES0.INSTANCE0.MODBUS_WRITE1.REG_07 | CONFIG0.RES0.INSTANCE0.MODBUS_WRITE1.REG_07 | INT | INT | 0
185 | VAR | CONFIG0.RES0.INSTANCE0.MODBUS_WRITE1.REG_08 | CONFIG0.RES0.INSTANCE0.MODBUS_WRITE1.REG_08 | INT | INT | 0
186 | VAR | CONFIG0.RES0.INSTANCE0.MODBUS_WRITE1.DONE | CONFIG0.RES0.INSTANCE0.MODBUS_WRITE1.DONE | BOOL | BOOL | 0
187 | VAR | CONFIG0.RES0.INSTANCE0.MODBUS_WRITE1.ERROR | CONFIG0.RES0.INSTANCE0.MODBUS_WRITE1.ERROR | BOOL | BOOL | 0
188 | VAR | CONFIG0.RES0.INSTANCE0.MODBUS_WRITE1.HASBEENINITIALIZED | CONFIG0.RES0.INSTANCE0.MODBUS_WRITE1.HASBEENINITIALIZED | BOOL | BOOL | 0
189 | VAR | CONFIG0.RES0.INSTANCE0.MB_WRITE_REGS_DONE | CONFIG0.RES0.INSTANCE0.MB_WRITE_REGS_DONE | BOOL | BOOL | 0
190 | VAR | CONFIG0.RES0.INSTANCE0.MB_SLAVE_AO01 | CONFIG0.RES0.INSTANCE0.MB_SLAVE_AO01 | REAL | REAL | 0
191 | VAR | CONFIG0.RES0.INSTANCE0.MB_SLAVE_AO02 | CONFIG0.RES0.INSTANCE0.MB_SLAVE_AO02 | REAL | REAL | 0
192 | VAR | CONFIG0.RES0.INSTANCE0.MB_SLAVE_AO03 | CONFIG0.RES0.INSTANCE0.MB_SLAVE_AO03 | REAL | REAL | 0
193 | VAR | CONFIG0.RES0.INSTANCE0.MB_SLAVE_AO04 | CONFIG0.RES0.INSTANCE0.MB_SLAVE_AO04 | REAL | REAL | 0
194 | VAR | CONFIG0.RES0.INSTANCE0.MB_SLAVE_AO5 | CONFIG0.RES0.INSTANCE0.MB_SLAVE_AO5 | INT | INT | 0
195 | VAR | CONFIG0.RES0.INSTANCE0.MB_SLAVE_AO01_TEMP | CONFIG0.RES0.INSTANCE0.MB_SLAVE_AO01_TEMP | INT | INT | 0
196 | VAR | CONFIG0.RES0.INSTANCE0.MB_SLAVE_AO02_TEMP | CONFIG0.RES0.INSTANCE0.MB_SLAVE_AO02_TEMP | INT | INT | 0
197 | VAR | CONFIG0.RES0.INSTANCE0.MB_WRITE_REGS_DONE0 | CONFIG0.RES0.INSTANCE0.MB_WRITE_REGS_DONE0 | BOOL | BOOL | 0
198 | VAR | CONFIG0.RES0.INSTANCE0._TMP_REAL_TO_INT5408527_ENO | CONFIG0.RES0.INSTANCE0._TMP_REAL_TO_INT5408527_ENO | BOOL | BOOL | 0
199 | VAR | CONFIG0.RES0.INSTANCE0._TMP_REAL_TO_INT5408527_OUT | CONFIG0.RES0.INSTANCE0._TMP_REAL_TO_INT5408527_OUT | INT | INT | 0
200 | VAR | CONFIG0.RES0.INSTANCE0._TMP_REAL_TO_INT3098114_ENO | CONFIG0.RES0.INSTANCE0._TMP_REAL_TO_INT3098114_ENO | BOOL | BOOL | 0
201 | VAR | CONFIG0.RES0.INSTANCE0._TMP_REAL_TO_INT3098114_OUT | CONFIG0.RES0.INSTANCE0._TMP_REAL_TO_INT3098114_OUT | INT | INT | 0
202 | FB | CONFIG0.RES0.INSTANCE1 | CONFIG0.RES0.INSTANCE1 | MODBEE |  | 0
203 | FB | CONFIG0.RES0.INSTANCE1.MODBEE_HW_CONFIG0 | CONFIG0.RES0.INSTANCE1.MODBEE_HW_CONFIG0 | MODBEE_HW_CONFIG |  | 0
204 | VAR | CONFIG0.RES0.INSTANCE1.MODBEE_HW_CONFIG0.EN | CONFIG0.RES0.INSTANCE1.MODBEE_HW_CONFIG0.EN | BOOL | BOOL | 0
205 | VAR | CONFIG0.RES0.INSTANCE1.MODBEE_HW_CONFIG0.ENO | CONFIG0.RES0.INSTANCE1.MODBEE_HW_CONFIG0.ENO | BOOL | BOOL | 0
206 | VAR | CONFIG0.RES0.INSTANCE1.MODBEE_HW_CONFIG0.HASBEENINITIALIZED | CONFIG0.RES0.INSTANCE1.MODBEE_HW_CONFIG0.HASBEENINITIALIZED | BOOL | BOOL | 0
// Ticktime
1000000
