mod-bee/modbee-node-uio/schematics/modbee-node-uio.pdf

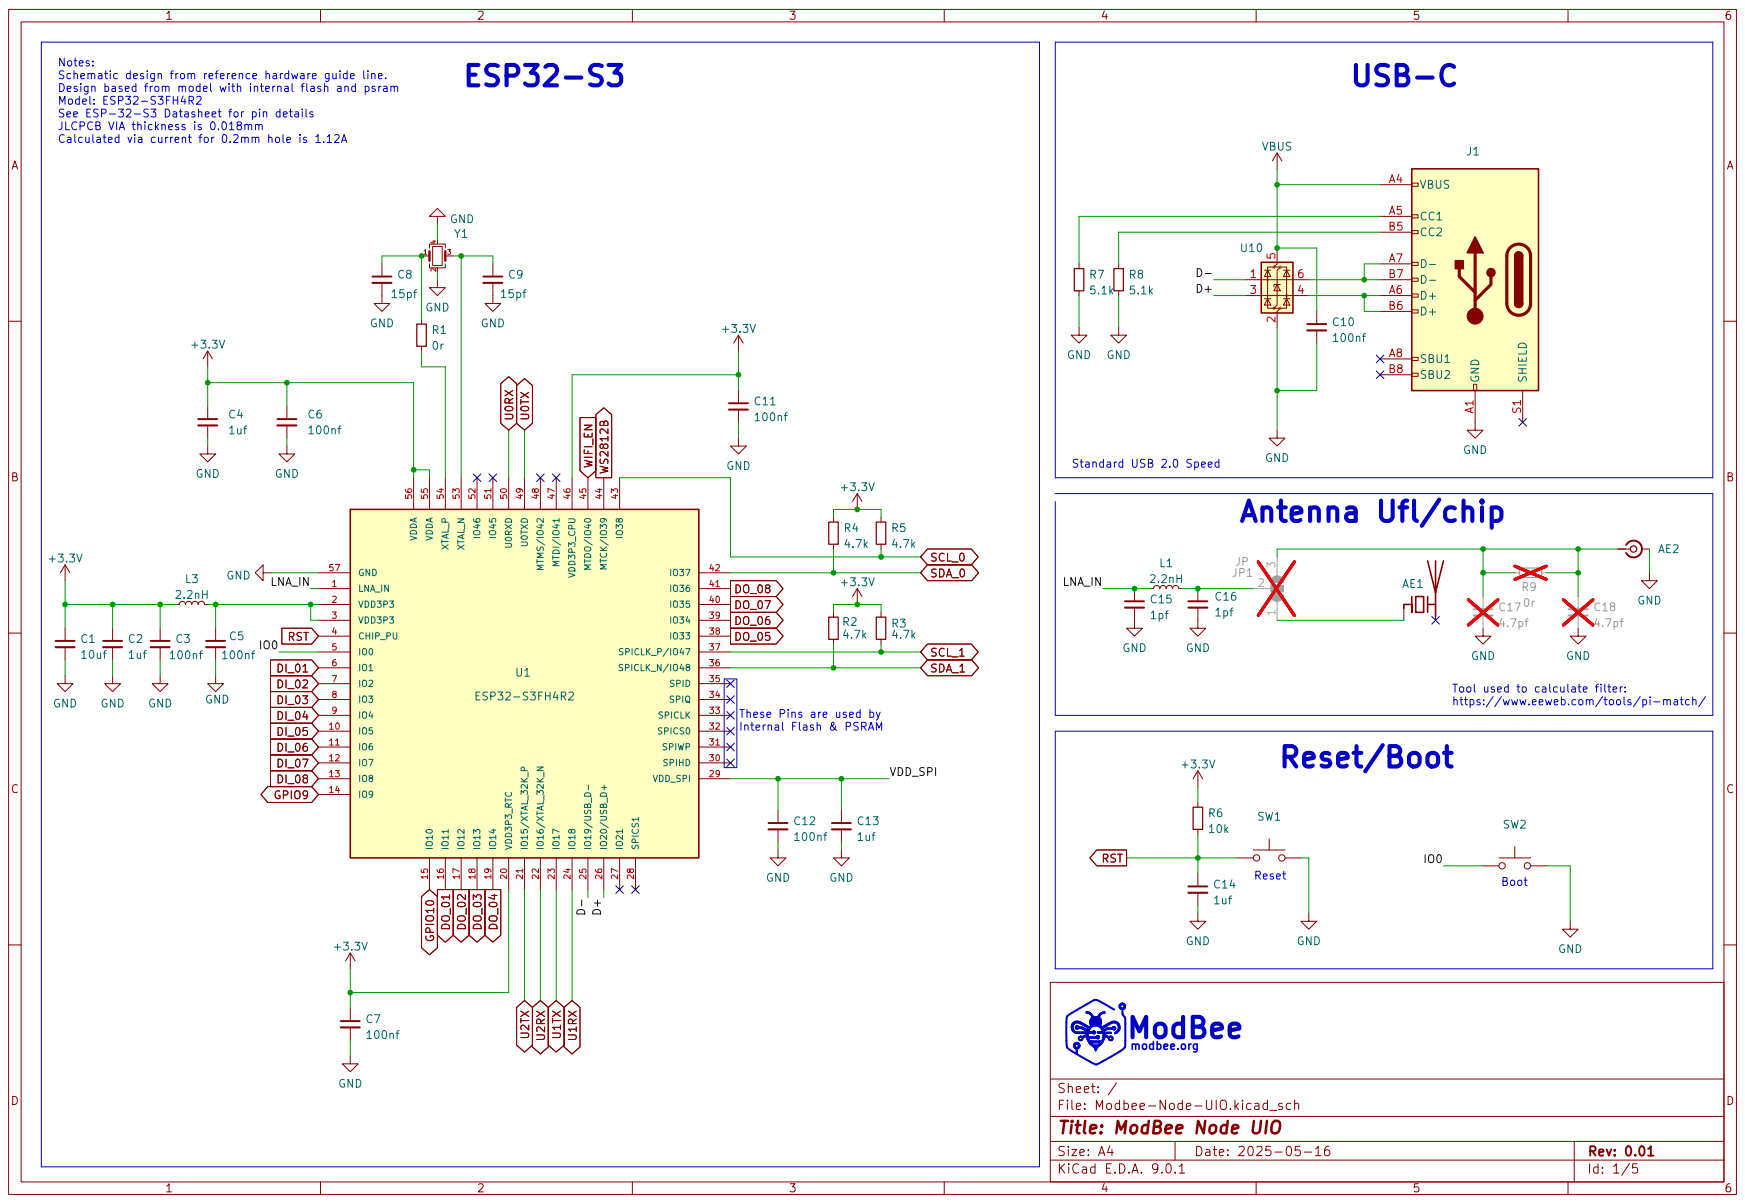
[picture p14: page 1]

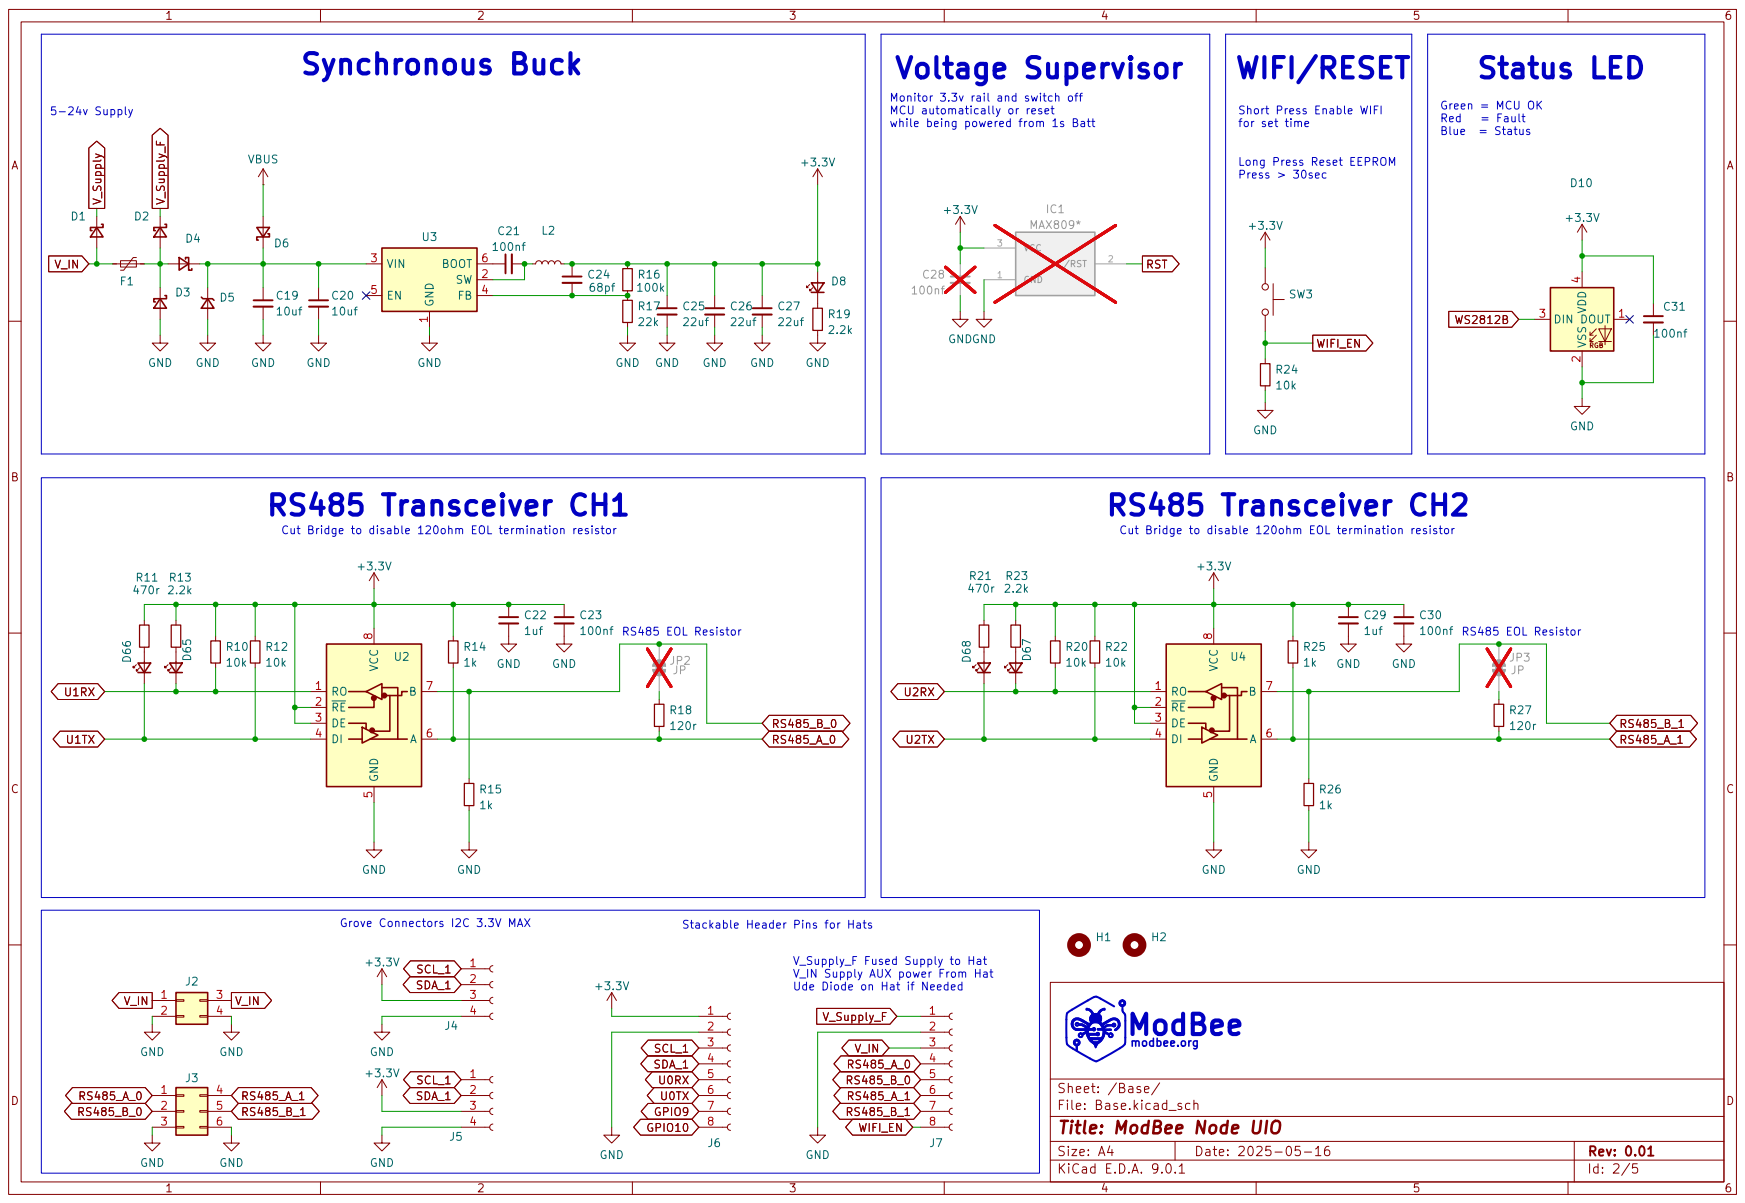
[picture p15: page 2]

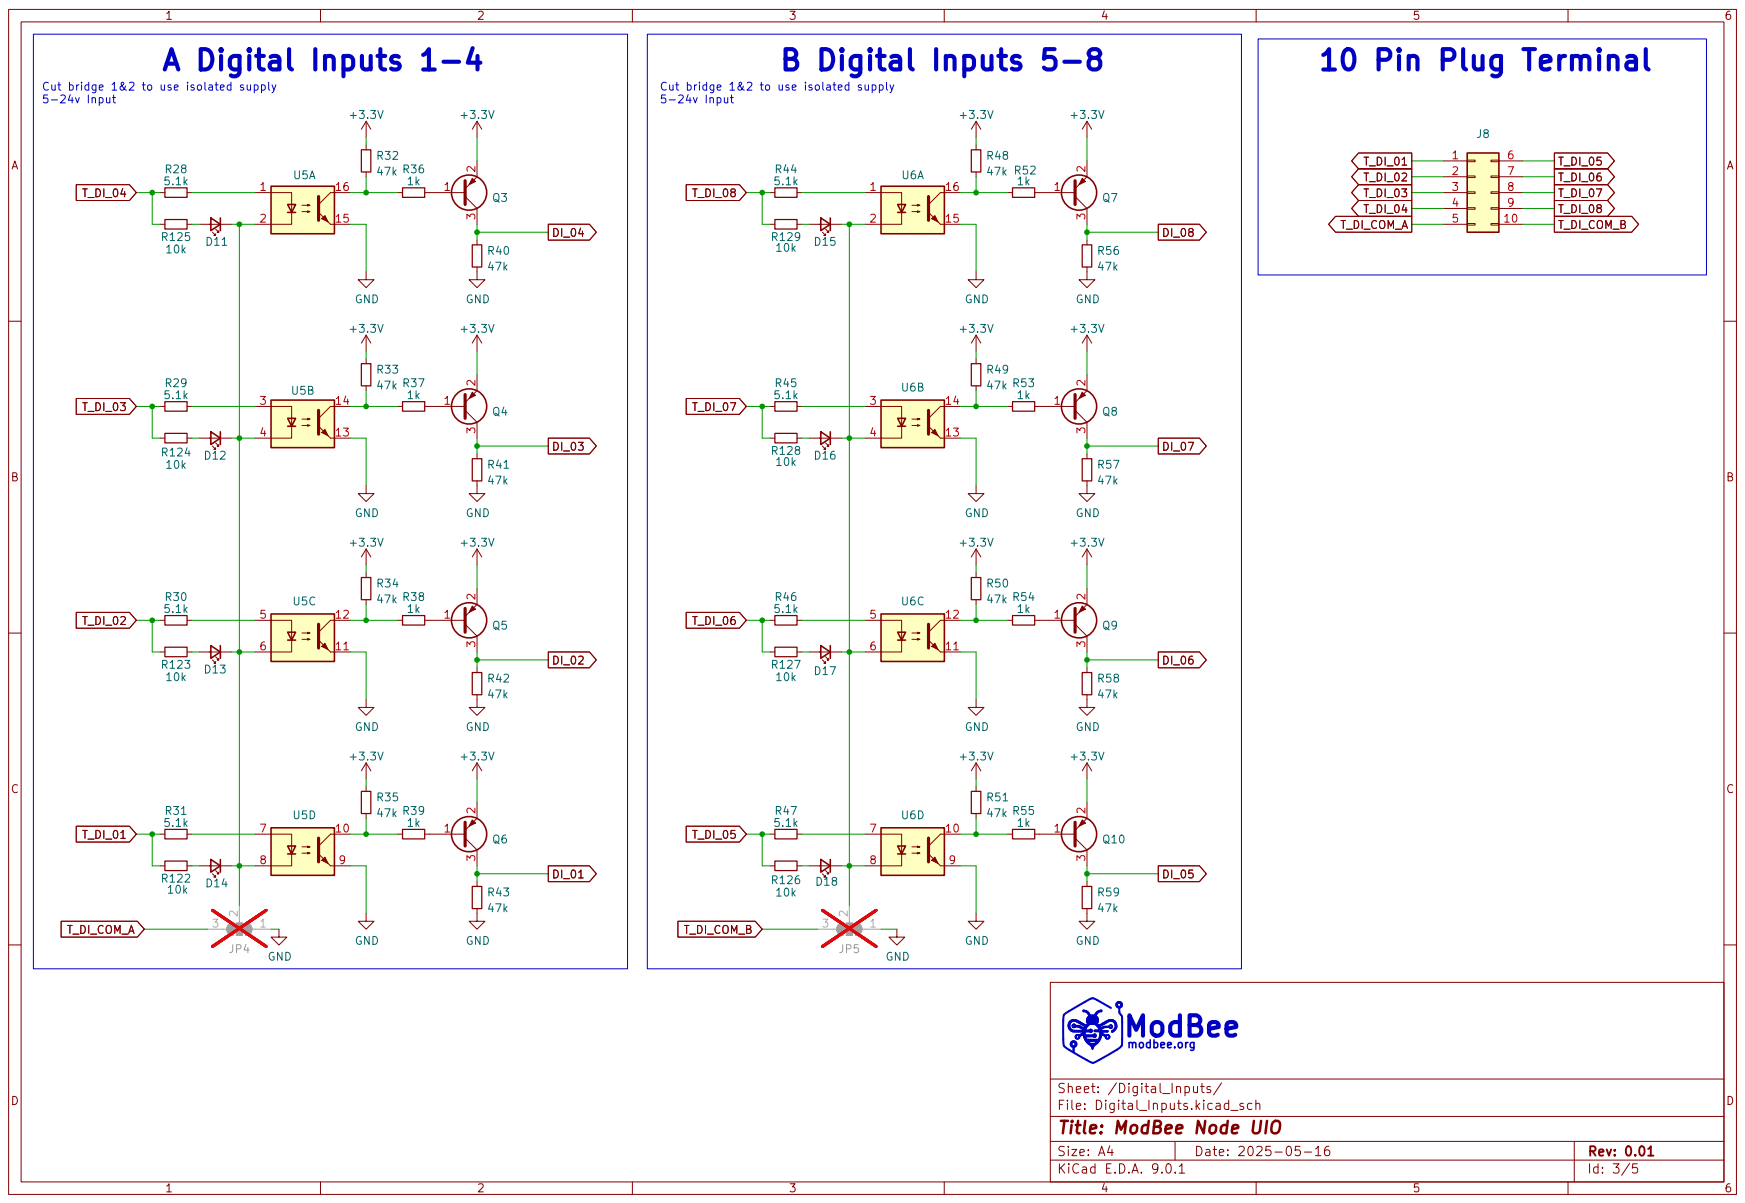
[picture p16: page 3]

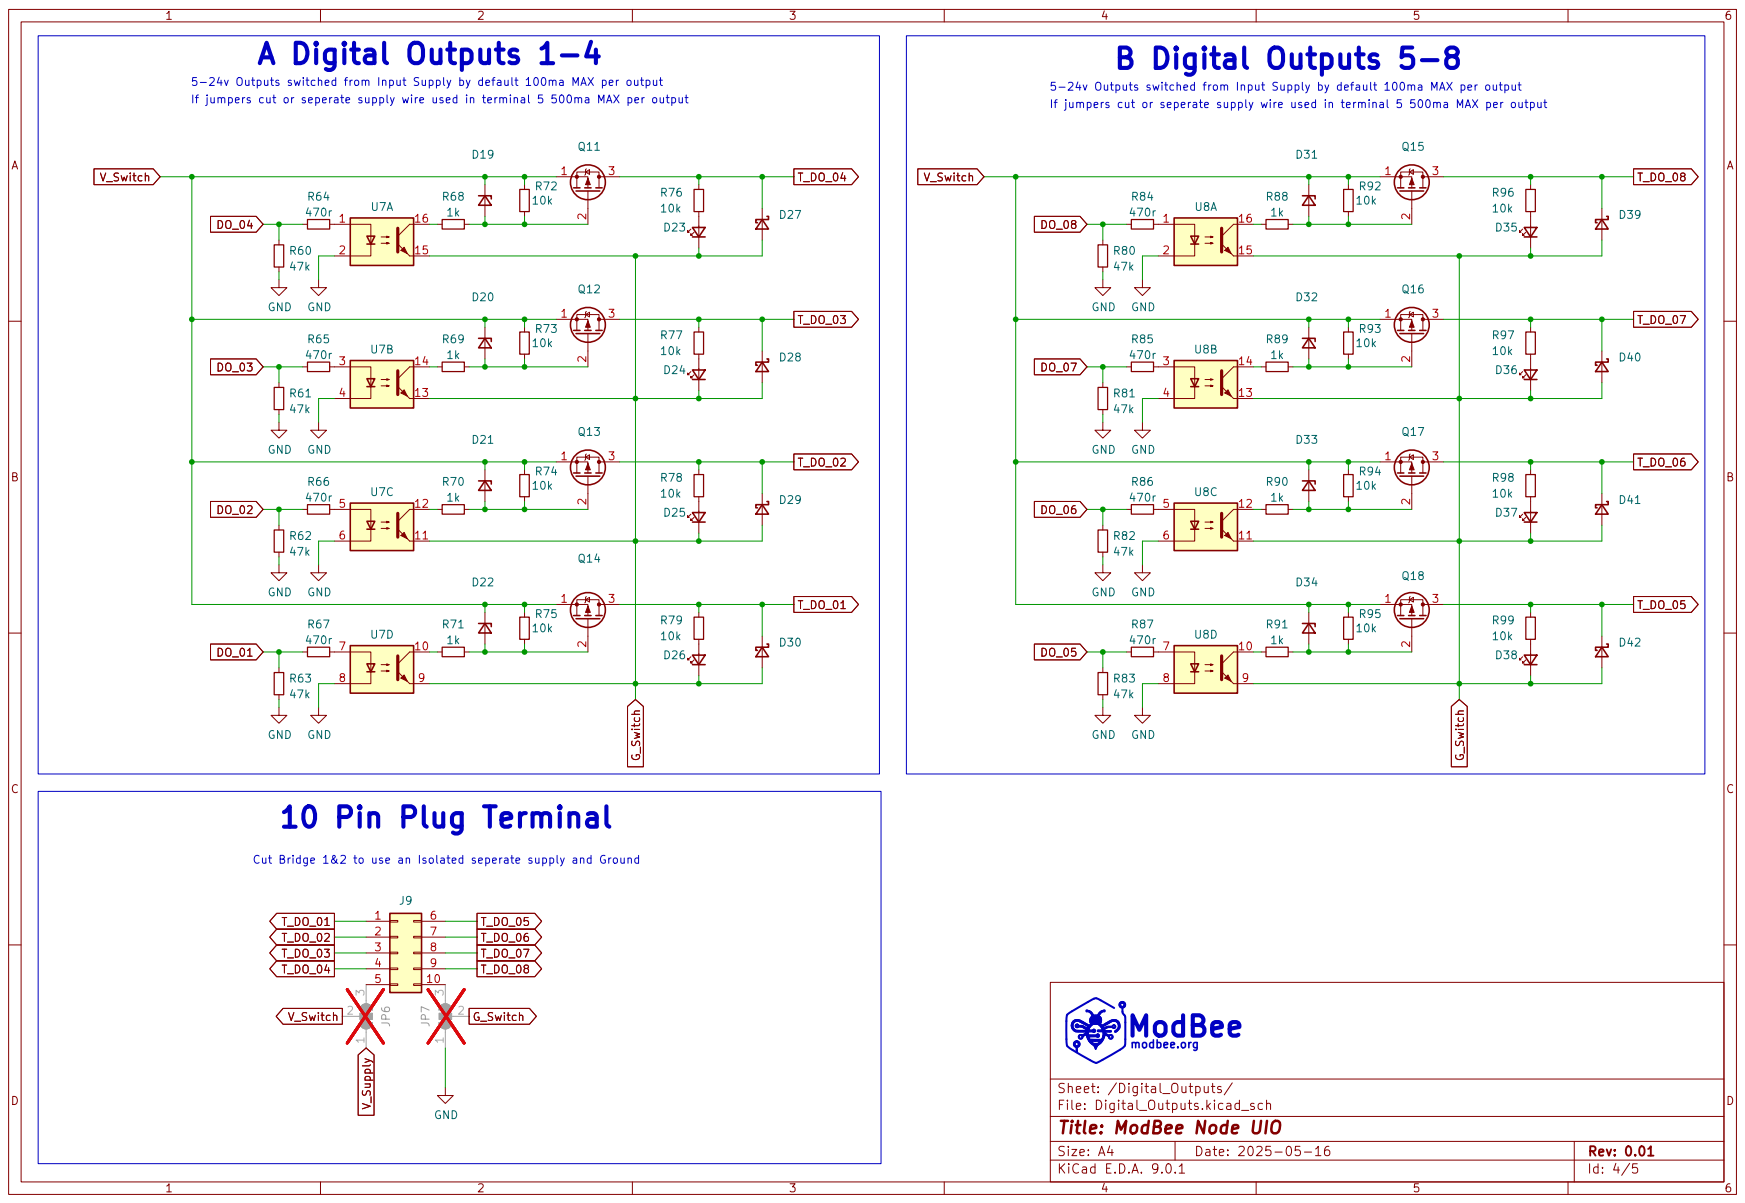
[picture p17: page 4]

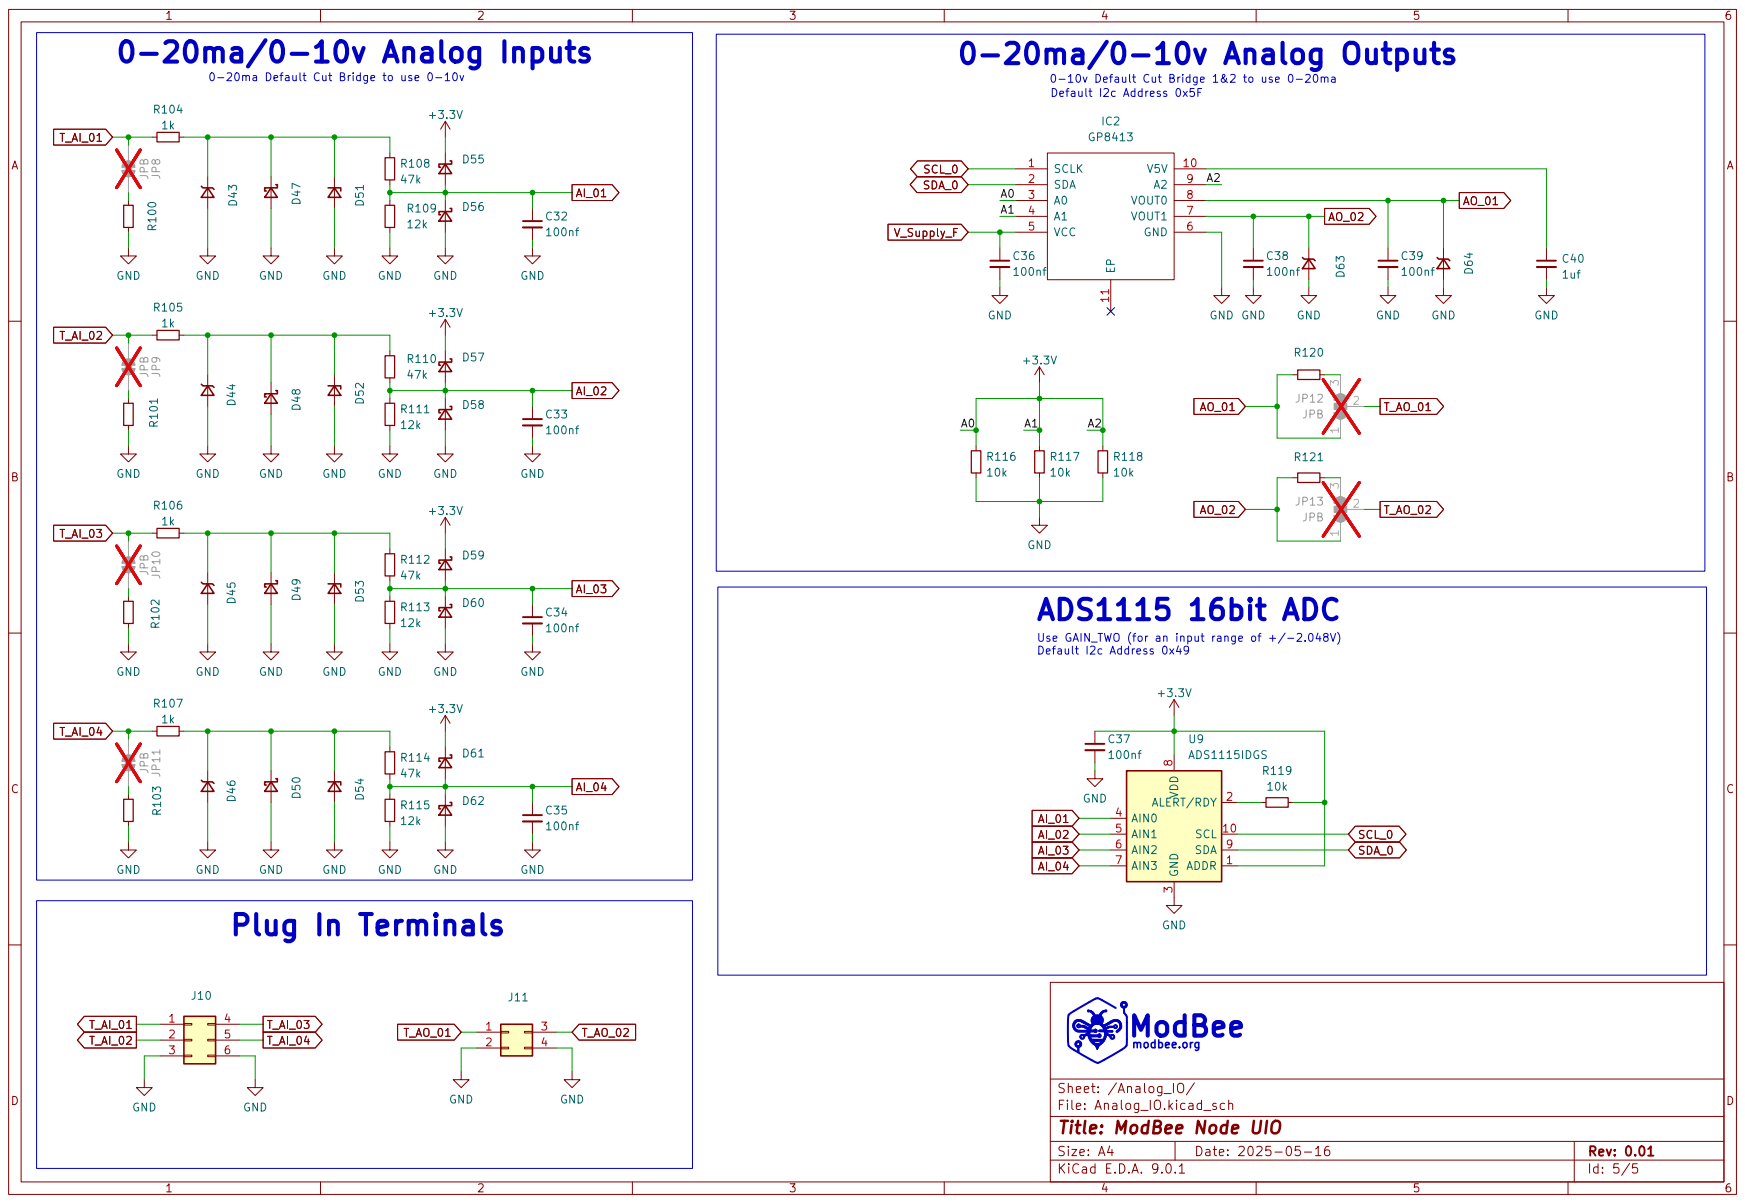
[picture p18: page 5]
