mod-bee/modbee-node-uio/(commit log)

2026-02-18 Add OpenPLC V4 Support
    [VARIABLES.csv, partitions.csv]
2026-03-03 Update OpenPLC Function Blocks and Add More Examples, update Modbee Protocol
    [VARIABLES.csv, partitions.csv]
2026-03-04 Update Read Function Blocks to not set zero on error
    [MODBEE_READ_ARRAY.cpp, MODBUS_READ_ARRAY.cpp]
